randomizedcoder/rtl-fun/README.md

# rtl-fun

**Parser instructions for RISC-V — a CPU-in-the-datapath packet parser as an ISA extension.**

This project takes Tom Herbert's *"parser instructions"* idea — domain-specific
CPU instructions that make protocol parsing fast *and* fully programmable — and
carries it all the way to real RTL: a SystemVerilog RISC-V extension, verified
against a golden software model and prototyped on FPGA.

## Why

Protocol parsing is a parse-graph walk: for each header you must (1) determine
its length and (2) determine the next protocol. Fixed-function parsers are fast
but rigid; plain integer code is flexible but slow (dominated by load/shift/mask/
branch). Making the parser a set of *CPU instructions* gives both: hardware-speed
primitives that live inside a Turing-complete, fully programmable core, reusing
existing tool chains and operational practices.

Reference: Tom Herbert, ["Parser Instructions: World's fastest and most flexible
protocol parsing"](https://tomaherbert.com/parser-instructions-worlds-fastest-most-flexible-protocol-parsing-0d366cd4dfc5)
(US patent 12,461,885).

## Status

🔨 **Executing phase by phase.** The full [design-doc set](docs/README.md) is
complete; phases are now being built in order.

- ✅ **Phase 0 — Scope & stack:** base core locked (CVA6, RV64GC); the stock CVA6
  Verilator model builds end-to-end from Nix (`nix run .#cva6-baseline`) with the
  RISC-V cross-toolchain; reproducibility snapshot in
  [docs/environment.md](docs/environment.md).
- ✅ **Phase 1 — ISA spec:** normative, patent-cited
  [per-instruction semantics](docs/phase-1-isa-semantics.md) for the vertical slice.
- ✅ **Phase 2 — Golden model + corpus:** the C reference model
  (`model/libparsermodel`) parses Ethernet, VLAN (802.1Q/802.1ad, stacked), IPv4
  (with options), IPv6 (with hop-by-hop/routing/fragment/dest-opts extension
  headers), TCP and UDP into a `flow_keys`. It passes directed, malformed (§2.3),
  and corpus tests against a pinned [xdp2](https://github.com/randomizedcoder/xdp2)
  `proto_audit` corpus — all 306 Ethernet pcaps terminate cleanly, no
  crashes/hangs (`nix run .#model-test`). Debug a parse with `nix run .#pm-trace`.
- ✅ **Phase 3 — Instruction encoding:** the patent's bit-accurate scheme
  (custom-0 `0x0b` + `Fnc4`; custom-3 `0x7b` coprocessor) as a machine-readable
  table ([`isa/parser-opcodes.yaml`](isa/parser-opcodes.yaml)) with a C
  encoder/decoder in the model and `.insn` emitters
  ([`toolchain/parser_insn.h`](toolchain/parser_insn.h)); every slice instruction
  round-trips (`nix run .#model-test`).
- ✅ **Phase 4 — Microarchitecture:** the parser datapath (align → endian →
  shift/mask extract, bounds/length/compare, CAM, two-stage end-of-node), a 256 B
  packet buffer with a 128-bit read window, and a 32×64-bit parser register file
  with a single-in-flight hazard interlock — all decided at signal-interface
  granularity. The CVA6 integration is mapped to the **pinned v5.3.0 source**
  ([`docs/analysis/cva6-integration.md`](docs/analysis/cva6-integration.md)):
  custom-0 becomes a new in-pipeline `fu_t::PARSER` that reuses CVA6's
  `resolved_branch_o` path for end-of-node fetch redirect, and the custom-3
  coprocessor moves attach via CV-X-IF.
- ✅ **Phase 5 — RTL:** the parser datapath is implemented in
  synthesizable SystemVerilog ([`rtl/`](rtl/README.md)) as a hardware `pm_run` and
  **runs the vertical slice in Verilator, producing a `flow_keys` that matches the
  golden model byte-for-byte** (`nix run .#parser-sim`). Lint-clean under `-Wall`,
  with four Verilator targets at different debug levels
  (`parser-sim{,-trace,-debug}`, `parser-lint`). The 32-bit word decoder
  (`parser_decode.sv`) is proven equivalent to the model over the whole suite
  (`nix run .#parser-sim-decode`), and the **in-core CVA6 patch is complete**:
  custom-0/custom-3 route to a new `fu_t::PARSER`, issue over a ready/valid
  handshake, execute in the EX-stage FU (`cva6_parser_wrap`), retire via a new
  writeback port, and can redirect fetch via `resolved_branch_o`. The patched core
  builds (`nix run .#cva6-parser`) with no baseline regression, and a bare-metal
  custom-0 program **issues, executes, and retires in-core**
  (`nix run .#cva6-parser-test` → fesvr `tohost` PASS). The **packet-data feed + CAM
  programming are real** (I5): a SoC AXI MMIO peripheral (`nix/cva6-parser/
  mmio.patch`) bridges `sd`/`ld` into the FU's `parser_pktbuf` write port + commit-gated
  flow_keys frame, and the CAM is programmed at runtime from the integer side — so a
  program parses a packet end-to-end in-core. All exit criteria met; the lone leftover
  (generate `parser_pkg` from `isa/`) is a cosmetic refactor, not a gate.
- ✅ **Phase 6 — Verification:** the correctness gate is met — the RTL is proven
  equal to the golden model (fields **and** exit status) across the corpus, and the
  in-core FU is verified end-to-end. The foundation is green across all four
  techniques from the flake: **toggleable design assertions**
  (`rtl/parser_asserts.svh`, on in every sim, gone from synthesis); **SymbiYosys
  formal proofs** — `parser_execute` never writes metadata out of bounds / always
  exits valid, and `cva6_parser_wrap` never leaks speculative parser state past a
  flush (G2 k-induction), for all inputs (`nix run .#parser-formal`); a **directed
  suite** of 22 positive / negative / boundary / corner packets — IPv4/IPv6, VLAN,
  QinQ, IPv6 ext + fragment, malformed and truncated — each matched byte-for-byte and
  by exit code against the model (`nix run .#parser-sim-suite`); and **static
  analysis + fuzzing** — verible + svlint on the RTL (`nix run .#parser-analyze`),
  cppcheck + gcc `-fanalyzer` + clang-tidy + ASan/UBSan on the model
  (`nix run .#model-analyze`), and libFuzzer + ASan/UBSan on random packets
  (`nix run .#model-fuzz`). The in-core FU is hardened through increments **I1–I5**
  (see the [status tracker](docs/analysis/cva6-implementation-status.md)), culminating
  in the full **in-core packet→flow_keys co-simulation over real MMIO** — all 22 corpus
  packets parse in the CVA6 pipeline and match the model **byte-for-byte + exit code**
  (`nix run .#cva6-parser-cosim`, 22/22). A **per-instruction RVFI-vs-Spike lock-step**
  then steps an extended Spike (its custom extension reuses `libparsermodel`) beside
  the core and compares every retired instruction — base ISA (287/287), parser ops
  (43/0), the 22-packet corpus (0 mismatches) — plus a **constrained-random +
  real-corpus packet campaign** (`nix run .#cva6-parser-tandem` /
  `.#cva6-parser-tandem-campaign`). *(That lock-step tandem is the project's Phase-6
  verification oracle; its PRs are commit-tagged "Phase 7 Stage N", but the work is
  classified as Phase-6 verification, not the Phase-7 toolchain.)* Sign-off is
  complete: **negative control** (`nix run .#parser-negative-control`, G11),
  **base-ISA regression** (`nix run .#cva6-parser-baseisa`), a **2nd config**
  (`nix run .#cva6-parser-config-wb`, G10), the interrupt / fault / context-switch
  rows (V6/V7/V10/M1), and **coverage closure** (`nix run .#parser-coverage`, 100% of
  the functional op×event×exit bins, G12). Gaps **G1–G13 are closed**; **G14
  (timing/physical) belongs to Phase 8**. The only §6.1 item not built as literally
  specified — a **cocotb + DPI-C** corpus harness — is *superseded*: its goal is met
  by the Verilator suite + in-core MMIO cosim + tandem campaign.
- 🔵 **Phase 7 (in progress) — Toolchain:** the software-tooling ladder. **Level 1**
  (`.insn` + intrinsics, [`toolchain/parser_insn.h`](toolchain/parser_insn.h)) and
  **Level 2** (binutils as/objdump — a parser-patched `riscv64-none-elf` binutils
  assembles the `prs.*` mnemonics with readable, round-tripping disassembly — Hybrid
  syntax plus additive prose sugar `pcurptr+N`/`paccum[i]`/`value:mask`;
  `nix run .#parser-asm-test`) are done, **Level 4 Spike** runs standalone
  (`nix run .#parser-spike`: a runnable `spike` with the parser extension + `0x5000_0000`
  packet MMIO runs the 22-case corpus == the golden model — distinct from the Phase-6
  `spike-tandem` oracle), and the **slice parser is now authored in C** with the generated
  intrinsics ([`tests/cva6-parser/parser_slice.c`](tests/cva6-parser/parser_slice.c),
  `nix run .#parser-spike-slice`: byte-identical to the model ROM, 22-case corpus == model
  on the standalone Spike). **Level 4 QEMU** then teaches a patched `qemu-system-riscv64` the
  same ops + `0x5000_0000` device ([`nix/qemu-parser.nix`](nix/qemu-parser.nix)) and runs the
  identical ELFs and C slice on it (`nix run .#parser-qemu` / `.#parser-qemu-slice`, both
  22/0 == model) — so **the exit criterion is met: the C slice runs on Spike *and* QEMU ==
  the golden model** ✅. The prose-freeze follow-on is now **complete** too — the frozen §1.12
  notation (`.be`/`.stp`/`.fail` qualifiers, `mult:min`, the `prs.lenset{,min,const}` aliases, and
  the `paccum`/`pnext`/`pcurhdr` destination decoration) assembles, disassembles to the canonical
  prose, and round-trips, all bit-identical to the model. **LLVM MC** is progressing (`nix run
  .#parser-llvm-mc-test`): a RISCV-only patched `llvm-mc`/`llvm-objdump`, generated from the same
  ISA yaml, assembles + disassembles the immediate-only custom-0 ops (L1), the custom-3 moves via a
  generated `PRReg` register class (L2), the destination-decorated load/cam/length forms (L3a:
  `paccum`/`pnext`/`pcurhdr`), and the prose-sugar operands (L3b: `pcurptr+N`, `pmeta+N`,
  `paccum[i]`, `value:mask`, `mult:min`) to byte-identical goldens — full binutils parity for the
  MC layer (all 38 vector lines assemble + round-trip, 0 deferred). The **Clang** leg has stood up
  (C0, `nix run .#parser-clang-check`): a `clang` built against the parser-patched libLLVM whose
  integrated assembler assembles `prs.*` to the golden words and compiles the C slice byte-identical
  to the model ROM. On top of it, **C1** adds `__builtin_riscv_prs_*` — 67 first-class Clang builtins
  (one per assembly variant) generated from the same ISA yaml, with Sema immediate-range checking,
  each lowering to the `prs.*` mnemonic as inline asm (no IR intrinsics / ISel);
  `nix run .#parser-clang-builtins-test` proves every one emits the exact golden encoding (67/0).
  **C2** ran that C slice through the patched Clang using those builtins (`-DPRS_USE_BUILTINS`) on the
  standalone Spike over the 22-case corpus == the golden model, the 53-word byte-parity guard proving
  the builtins lowering is byte-identical to the intrinsics one (`nix run .#parser-clang-slice`). **C3**
  completes the leg with the custom-3 register-move builtins (`__builtin_riscv_prs_mv_x_p` / `mv_p_x` /
  `cam_read` / `array_read`) — reading/writing the parser p-registers from Clang — verified by a
  table-driven masked encoding check plus a builtins-only p-register round-trip on Spike
  (`nix run .#parser-clang-moves`). The exit criterion is met and the whole toolchain ladder a C
  programmer needs is built; what remains is a **follow-up tail** (optional GCC **builtins**, the
  unfrozen `prs.ld.immed` immediate spelling, and the heavyweight random-*instruction* checks — full
  upstream riscv-tests; riscv-dv, blocked on a commercial UVM simulator), none of it on the critical
  path — so **Phase 8 can begin**. The deferred items are enumerated in
  [docs/phase-7-toolchain.md](docs/phase-7-toolchain.md#follow-up--deferred-work).

- 🔵 **Phase 8 (in progress) — FPGA:** the board is real. A **Sipeed Tang Mega 138K Pro**
  (Gowin `GW5AST-LV138FPG676AC1/I0` — 138,240 LUT4, 1 GB DDR3, 2× SFP+) arrived and was
  powered up on **2026-09-07**, unblocking the one thing this phase was waiting for.
  Current scope is board bring-up: prove we can talk to it, program it, and run **our own**
  RTL on it. The programming path is in the flake — `nix run .#fpga-detect` (scan the JTAG
  chain), `.#fpga-load` / `.#fpga-flash` (SRAM / SPI flash), `.#fpga-build` (synthesize via
  Gowin EDA in the licensed microVM) — Gowin EDA is now a derivation rather than a
  hand-extracted directory ([`nix/gowin-eda.nix`](nix/gowin-eda.nix)), and the first design
  we build ourselves lives in [`fpga/tang-mega-138k-pro/`](fpga/tang-mega-138k-pro/).
  The standing hands-on reference — pin map, the two USB ports, Gowin gotchas — is
  [docs/fpga-bringup-tang-mega-138k-pro.md](docs/fpga-bringup-tang-mega-138k-pro.md);
  progress, measurements and the challenge log are in
  [docs/phase-8-status.md](docs/phase-8-status.md).
  **M0 (bring-up), M1 (parser unit alone) and M2 (host packet injection) are done and
  verified on the board:** the parser datapath runs on the FPGA and produces `flow_keys`
  that match `libparsermodel` byte-for-byte — M1 from a ROM-baked packet
  (`nix run .#fpga-m1-check`), M2 for the **whole 22-case suite injected over UART**
  (`nix run .#fpga-m2-inject -- --suite`, 22/22). GowinSynthesis can't ingest our RTL
  directly (an `SP00018` front-end bug), so the flow is sv2v → yosys flatten → Gowin
  (`nix run .#fpga-m{1,2}-rtl`). The debug UART's RX pin is CPU-locked, so M2 injects over
  an external 3.3 V USB-UART on PMOD2. Next is **M3 (stock CVA6 on the FPGA)**; its known
  blocker is BRAM inference for CVA6's SRAM macros
  ([docs/fpga-platform-assessment.md](docs/fpga-platform-assessment.md) §5a).

The parser unit now exists as synthesizable RTL ([`rtl/`](rtl/README.md)), with its
testbenches in [`tb/`](tb/README.md) and the vector generator + formal harness in
[`verif/`](verif/README.md); `fpga/` now holds the Tang Mega board designs, and `corpus/`
remains a skeleton until its phase lands (per-phase status: [docs/README.md](docs/README.md)). Deferred: 64-bit instruction
form, the array/counter/TLV-loop encoder+execution, and tunnel protocols
(GRE/GTP/VXLAN).

## Repo map

```
docs/          Design documentation (start here; testing map: docs/testing-overview.md)
model/         Golden C reference model            (Phase 2)
isa/           Machine-readable encoding tables     (Phase 3)
rtl/           SystemVerilog parser unit — synthesizable RTL only (Phase 5)
tb/            SystemVerilog testbenches (scaffold + smoke + wrap) (Phase 6)
verif/         Vector generator (verif/gen) + formal harness (verif/formal) (Phase 6)
tests/         In-core CVA6 test programs (parser_insn.S, cosim_main.S) (Phase 5/6)
scripts/       Bodies of the `nix run .#<app>` runners (readFile'd into nix)
tools/         Reusable dev utilities (pm-trace, bitgen)
corpus/        Packet corpus skeleton (incl. malformed) (Phase 2)
toolchain/     .insn macros, intrinsics, MMIO map      (Phase 7)
fpga/          Board designs + Gowin build scripts  (Phase 8)
bench/         Benchmark harness + results          (Phase 9)
flake.nix      Nix flake — reproducible dev environment (`nix develop`)
nix/           Modular Nix files (tool groups, dev shell, CVA6 patches)
LICENSE        Public domain (Unlicense)
```

## Development environment

All tooling (Verilator, cocotb, poppler, Spike, QEMU, …) is provided by a **Nix
flake** so every contributor gets the same versions:

```sh
nix develop      # enter the dev shell
rtl-help         # list the tools
```

See **[docs/nix.md](docs/nix.md)** for the layout and how to extend it.

## Read the docs

| Doc | What it covers |
|-----|---|
| [docs/README.md](docs/README.md) | Index + reading order + phase status |
| [docs/00-overview.md](docs/00-overview.md) | **The whole-project design doc — start here** |
| [docs/testing-overview.md](docs/testing-overview.md) | **How the parser is tested** — the four test layers + which `nix run` runs each |
| [Phase 0 — Scope & stack](docs/phase-0-scope-and-stack.md) | Goals, core selection, first vertical slice |
| [Phase 1 — ISA spec](docs/phase-1-isa-spec.md) | Parser registers & instruction semantics |
| [Phase 2 — Reference model](docs/phase-2-reference-model.md) | Golden C model + packet corpus |
| [Phase 3 — Encoding](docs/phase-3-encoding.md) | `custom-0..3` opcode allocation |
| [Phase 4 — Microarchitecture](docs/phase-4-microarchitecture.md) | Parser datapath & core integration |
| [Phase 5 — RTL](docs/phase-5-rtl.md) | SystemVerilog implementation |
| [Phase 6 — Verification](docs/phase-6-verification.md) | Co-simulation vs golden model |
| [Phase 7 — Toolchain](docs/phase-7-toolchain.md) | Assembler, LLVM/GCC, Spike/QEMU |
| [Phase 8 — FPGA](docs/phase-8-fpga.md) · [**status**](docs/phase-8-status.md) · [board manual](docs/fpga-bringup-tang-mega-138k-pro.md) | Prototype & bring-up |
| [Phase 9 — Benchmark](docs/phase-9-benchmark.md) | flow_dissector comparison |

## How to read

Read `docs/00-overview.md` first for the full picture, then follow the phase docs
in order. Each phase doc is self-contained and links to the previous/next phase.
Anything not yet locked down is marked **TBD** or **Decision** so the docs stay
honest about what's decided vs. open.
