randomizedcoder/rtl-fun/docs/README.md

# Design docs — index

This folder plans the entire project: from Tom Herbert's *parser instructions*
concept to real SystemVerilog RTL for a RISC-V ISA extension, verified against a
golden model and prototyped on FPGA.

## Reading order

1. **[00-overview.md](00-overview.md)** — the centerpiece design doc. Read first.
2. The phase docs, in order (each builds on the last):

| Phase | Doc | Objective | Status |
|---:|-----|---|---|
| 0 | [Scope & stack](phase-0-scope-and-stack.md) | Lock goals, base core, first vertical slice | ✅ Done |
| 1 | [ISA spec](phase-1-isa-spec.md) · [**semantics**](phase-1-isa-semantics.md) | Define parser registers & instruction semantics | ✅ Done |
| 2 | [Reference model](phase-2-reference-model.md) | Golden C model + packet corpus | ✅ Done |
| 3 | [Encoding](phase-3-encoding.md) | Allocate `custom-0..3` opcodes & formats | ✅ Done |
| 4 | [Microarchitecture](phase-4-microarchitecture.md) | Parser datapath + core integration | ✅ Done |
| 5 | [RTL](phase-5-rtl.md) | SystemVerilog implementation | ✅ Done |
| 6 | [Verification](phase-6-verification.md) | Co-sim RTL vs golden model | ✅ Done |
| 7 | [Toolchain](phase-7-toolchain.md) | Assembler → LLVM/GCC → Spike/QEMU | 🔵 In progress |
| 8 | [FPGA](phase-8-fpga.md) · [**status**](phase-8-status.md) · [board manual](fpga-bringup-tang-mega-138k-pro.md) | Prototype & bring-up on hardware | 🔵 In progress |
| 9 | [Benchmark](phase-9-benchmark.md) | flow_dissector comparison | 🟡 Draft |

Status legend (tracks phase **execution**, not just the doc):
🟡 Draft (design written, not yet executed) · 🔵 In progress (being executed) ·
✅ Done (executed & merged to `main`).

**Progress:** Phase 0 done — CVA6 Verilator baseline builds from Nix
(`nix run .#cva6-baseline`) with the RISC-V cross-toolchain and a reproducibility
snapshot ([environment.md](environment.md)). Phase 1 done — the normative
[per-instruction semantics](phase-1-isa-semantics.md) are complete and patent-cited.
Phase 2 done — the golden C model (`model/libparsermodel`) parses Ethernet,
802.1Q/802.1ad VLAN (incl. stacked), IPv4 (with options), IPv6 (with hop-by-hop /
routing / fragment / dest-opts extension headers), TCP and UDP into a `flow_keys`.
It passes directed unit tests, hostile/malformed cases (§2.3), and a robustness
sweep over the pinned xdp2 `proto_audit` corpus — all 306 Ethernet pcaps
terminate cleanly, no crashes/hangs (`nix run .#model-test`). A single-step
tracer lives in [tools/pm-trace](../tools/README.md).
Phase 3 done — the bit-accurate encoding is captured as a machine-readable table
([`isa/parser-opcodes.yaml`](../isa/parser-opcodes.yaml)), with a C encoder/decoder
wired into the model ([`encoding.c`](../model/libparsermodel/encoding.c)) and
`.insn` emitters ([`toolchain/parser_insn.h`](../toolchain/parser_insn.h)). Every
instruction in the slice program encodes to its exact custom-0 word and decodes
back (round-trip + golden-vector tests in `nix run .#model-test`).
Phase 4 done — the parser microarchitecture is decided at signal-interface
granularity: a 256 B packet buffer with a 128-bit read window, the extract/length/
compare/CAM/end-of-node datapath and its unit interfaces, a 32×64-bit parser
register file with a single-in-flight hazard interlock, and a CVA6 integration
plan mapped to the **pinned v5.3.0 source** — custom-0 as a new in-pipeline
`fu_t::PARSER` reusing `resolved_branch_o` for end-of-node redirect, custom-3 via
CV-X-IF ([`analysis/cva6-integration.md`](analysis/cva6-integration.md)).
Phase 5 done — the parser datapath is implemented in synthesizable
SystemVerilog ([`rtl/`](../rtl/README.md)) as a hardware `pm_run`, and **runs the
vertical slice in Verilator producing a `flow_keys` that matches the golden model
byte-for-byte** (`nix run .#parser-sim`). Lint-clean under `-Wall`, with four
Verilator targets at different debug levels (run / trace / debug / lint). The FU
also runs in-core in CVA6: the decode/issue/EX/retire patch is complete, the
32-bit-word decoder (`parser_decode`) is proven vs the model, and a packet parses
end-to-end in the pipeline over real MMIO ([`analysis/cva6-integration.md`](analysis/cva6-integration.md) §8).
All Phase-5 exit criteria are met; the one remaining nicety — generating
`parser_pkg` constants from `isa/` — is a cosmetic refactor, not a gate.
Phase 6 done — the correctness gate is met: the RTL is proven equal to the
golden model (fields **and** exit status) across the corpus, and the in-core FU is
verified end-to-end. The verification *foundation* is green across all four
techniques from the flake: (1) **toggleable design assertions**
(`rtl/parser_asserts.svh`) compiled into every sim and vanishing from synthesis;
(2) **SymbiYosys formal proofs** — `parser_execute` never writes metadata out of
bounds and always exits with a valid code, and `cva6_parser_wrap` never leaks
speculative parser state past a flush (G2 k-induction) — for *all* inputs
(`nix run .#parser-formal`); (3) a **directed suite** of 22 positive / negative /
boundary / corner packets — IPv4/IPv6, VLAN, QinQ, IPv6 ext + fragment, malformed
and truncated frames — each matched byte-for-byte and by exit code against the
model (`nix run .#parser-sim-suite`); and (4) **static analysis + fuzzing** —
verible + svlint on the RTL (`nix run .#parser-analyze`), cppcheck + gcc
`-fanalyzer` + clang-tidy + ASan/UBSan on the model (`nix run .#model-analyze`),
and libFuzzer + ASan/UBSan on random packets (`nix run .#model-fuzz`).
The in-core FU is hardened through increments **I1–I5**: the full **in-core
packet→flow_keys co-simulation over real MMIO** parses all 22 corpus packets in the
CVA6 pipeline and matches the model byte-for-byte + exit code
(`nix run .#cva6-parser-cosim`, 22/22). A **per-instruction RVFI-vs-Spike
lock-step** then steps an extended Spike beside the core and compares every retired
instruction — base ISA (287/287), the parser ops (43/0), and the 22-packet corpus
(0 mismatches) — with a **constrained-random + real-corpus packet campaign** layered
on top (`nix run .#cva6-parser-tandem` / `.#cva6-parser-tandem-campaign`). This
lock-step tandem (its Spike custom extension reuses `libparsermodel`) is the
project's **Phase-6 verification oracle** — the commit banners on those PRs say
"Phase 7 Stage N", but the work is classified here as Phase-6 verification, not the
Phase-7 toolchain. Sign-off is complete: **negative control**
(`nix run .#parser-negative-control`, G11), **base-ISA regression** on the patched
core (`nix run .#cva6-parser-baseisa`), a **2nd config** (`nix run
.#cva6-parser-config-wb`, G10), the interrupt / fault / context-switch rows
(V6/V7/V10/M1), and **coverage closure** (`nix run .#parser-coverage`, 100% of the
functional op×event×exit bins, G12). Gaps **G1–G13 are closed**; **G14
(timing/physical) is Phase 8**. The one item from the original §6.1 plan not built
as specified is the **cocotb + DPI-C** corpus harness — its goal (RTL == model over
the corpus) is met by the standalone Verilator suite + the in-core MMIO cosim + the
tandem campaign, so it is recorded as *superseded*, not outstanding.
Phase 7 in progress — the toolchain ladder. **Level 1** (`.insn` + intrinsics,
[`toolchain/parser_insn.h`](../toolchain/parser_insn.h)) and **Level 2** (binutils
as/objdump — a parser-patched `riscv64-none-elf` binutils assembles the `prs.*`
mnemonics with readable, round-tripping disassembly, generator-driven — Hybrid syntax plus
additive prose sugar (`pcurptr+N`, `paccum[i]`, `value:mask`); `nix run .#parser-asm-test`)
are done, **Level 4 Spike** runs standalone (`nix run .#parser-spike`: a runnable
`spike` with the parser extension + `0x5000_0000` packet MMIO, [`nix/spike-parser.nix`](../nix/spike-parser.nix),
runs the 22-case corpus == the golden model — distinct from the Phase-6 `spike-tandem` oracle),
and the **slice parser is now written in C** with the generated intrinsics
([`tests/cva6-parser/parser_slice.c`](../tests/cva6-parser/parser_slice.c),
`nix run .#parser-spike-slice`: byte-identical to the model ROM, 22-case corpus == model on the
standalone Spike). **Level 4 QEMU** teaches a patched `qemu-system-riscv64` the same ops +
`0x5000_0000` device ([`nix/qemu-parser.nix`](../nix/qemu-parser.nix)) and runs the identical
ELFs and C slice on it (`nix run .#parser-qemu` / `.#parser-qemu-slice`, both 22/0 == model) —
so **the exit criterion is met: the slice runs on Spike *and* QEMU == the golden model** ✅.
The prose-freeze follow-on is now **complete** — the frozen §1.12 notation (`.be`/`.stp`/`.fail`
qualifiers, `mult:min`, the `prs.lenset{,min,const}` aliases, `paccum`/`pnext`/`pcurhdr` destination
decoration) assembles, disassembles to the canonical prose, and round-trips, all bit-identical to
the model. **LLVM MC** is progressing (`nix run .#parser-llvm-mc-test`): a RISCV-only patched
`llvm-mc`/`llvm-objdump`, generated from the same ISA yaml, assembles + disassembles the
immediate-only custom-0 ops (L1), the custom-3 moves via a generated `PRReg` register class (L2),
the destination-decorated load/cam/length forms (L3a: `paccum`/`pnext`/`pcurhdr`), and the
prose-sugar operands (L3b: `pcurptr+N`, `pmeta+N`, `paccum[i]`, `value:mask`, `mult:min`) to
byte-identical goldens — full binutils parity for the MC layer (all 38 vector lines assemble +
round-trip, 0 deferred). The **Clang** leg has stood up (C0, `nix run .#parser-clang-check`): a
`clang` built against the parser-patched libLLVM, whose integrated assembler assembles `prs.*` to
the golden words and compiles the C slice byte-identical to the model ROM. On top of it, **C1** adds
`__builtin_riscv_prs_*` — 67 first-class Clang builtins (one per assembly variant) generated from the
same ISA yaml, with Sema immediate-range checking, each lowering to the `prs.*` mnemonic as inline asm
(no IR intrinsics / ISel); `nix run .#parser-clang-builtins-test` proves every one emits the exact
golden encoding (67/0). **C2** ran the Phase-0 C slice through the patched Clang using those builtins
(`-DPRS_USE_BUILTINS`) on the standalone Spike over the 22-case corpus == the golden model, the 53-word
byte-parity guard proving the builtins lowering is byte-identical to the intrinsics one
(`nix run .#parser-clang-slice`). **C3** completes the leg with the custom-3 register-move builtins
(`__builtin_riscv_prs_mv_x_p`/`mv_p_x`/`cam_read`/`array_read`, reading/writing the parser p-registers
from Clang) — a table-driven masked encoding check + a builtins-only p-register round-trip on Spike
(`nix run .#parser-clang-moves`). The exit criterion is met and the full toolchain ladder is built;
what remains is a **follow-up tail** — optional GCC **builtins**, the unfrozen `prs.ld.immed` immediate
spelling, and the heavyweight random-*instruction* checks (full upstream riscv-tests, riscv-dv — the
latter blocked on a commercial UVM simulator) — none of it on the critical path, so **Phase 8 can
begin**. The items are enumerated in
[phase-7-toolchain.md](phase-7-toolchain.md#follow-up--deferred-work).
Deferred slices: 64-bit instruction form; encoders/execution for the array /
counter / TLV-loop groups; TLV *extraction* loops and tunnel protocols.

Phase 8 in progress — the board is real. The **Sipeed Tang Mega 138K Pro**
(Gowin `GW5AST-LV138FPG676AC1/I0`) arrived and was powered up on 2026-09-07,
unblocking the one thing Phase 8 was waiting for. The hands-on reference is
[fpga-bringup-tang-mega-138k-pro.md](fpga-bringup-tang-mega-138k-pro.md) — pin map,
the two USB ports, the Gowin gotchas, and a live what-works/what-doesn't table.
The programming path is in the flake (`nix run .#fpga-detect` / `.#fpga-load` /
`.#fpga-flash` / `.#fpga-build`), Gowin EDA is now a derivation rather than a
hand-extracted directory ([`nix/gowin-eda.nix`](../nix/gowin-eda.nix)), and the
first design we build ourselves lives in
[`fpga/tang-mega-138k-pro/`](../fpga/tang-mega-138k-pro/). Current scope stops at a
self-built blinky; UART hello world is next, and the known blocker beyond it is
BRAM inference for CVA6's SRAM macros.

## Analysis

- **[analysis/cva6-integration.md](analysis/cva6-integration.md)** — the file/signal
  map for attaching the parser unit to CVA6, grounded in the pinned v5.3.0 source:
  custom opcodes, `fu_t::PARSER`, the `resolved_branch_o` end-of-node redirect,
  CV-X-IF for the custom-3 moves, and the Phase-5 patch checklist.
- **[analysis/cva6-test-evaluation.md](analysis/cva6-test-evaluation.md)** — a
  tapeout-oriented risk register for the **in-core** parser test: what
  `cva6-parser-test` actually proves, the bug-class gaps (incl. a speculation/flush
  state-corruption risk), and the industry best practices (lock-step co-sim,
  `riscv-dv`, RVFI/formal) to close them.
- **[analysis/cva6-verification-design.md](analysis/cva6-verification-design.md)** —
  the follow-up *design*: ordered implementation increments that close those gaps
  (starting with the speculation-safety fix), a **table-driven** verification
  framework (positive/negative/boundary/corner, model-generated oracles), and a
  **manufacturing/self-test (DFT)** section — scan/ATPG, MBIST/CAM-BIST for the
  parser memories, JTAG, and a golden-vector power-on self-test (POST).
- **[analysis/cva6-implementation-status.md](analysis/cva6-implementation-status.md)**
  — the **live progress tracker** for executing that design (increments I1–I5, gap
  burn-down G1–G14, verification-target snapshot). Updated per PR. I1
  (speculation-safety, commit-visible parser state), I2 (commit-gated metadata sink),
  I3 (custom-3 register readback), I4 (end-of-node + CAM-hit fetch redirect), and
  **I5** (all op classes + model-generated encodings + the table-driven in-core
  packet→flow_keys cosim over **real MMIO** — which closes the I2 sim-only-backdoor
  escalation) are all done and green in-core.
- **[analysis/cva6-parser-mmio.md](analysis/cva6-parser-mmio.md)** — the I5 SoC AXI
  MMIO parser peripheral: the address map (packet buffer, flow_keys frame, ParseLen /
  exit-PC / status registers), how `sd`/`ld` bridge through `axi2mem` into the FU, the
  gated parse-exit fetch redirect, and the **registered-read** gotcha (`axi2mem`
  advances the beat address combinationally, so a peripheral must present 1-cycle read
  data or every `ld` returns the next word).
- **[analysis/patent-conformance.md](analysis/patent-conformance.md)** — how the
  design compares to US Patent 12,461,885, and the prioritized corrections applied to
  follow Herbert's model closely.
- **[analysis/patent-encodings-recovered.md](analysis/patent-encodings-recovered.md)**
  — the authoritative bit-level reference: `Fnc4` opcode map, every 32-bit
  instruction format as RFC-style ASCII bit diagrams, the Parser Codes table, `Sz`
  tables, address/code + CAM-key formats, and register layouts (pixel-verified from
  the USPTO drawing sheets).

## Supporting docs

- **[testing-overview.md](testing-overview.md)** — **start here for "how is the parser
  tested?"** The one-stop map of the four test layers (golden-model unit/fuzz,
  standalone RTL-vs-model suite, in-core directed, in-core cosim-vs-model + formal),
  which `nix run .#<app>` runs each, where each lives, and how one generator feeds
  both the standalone suite and the cosim.
- **[fpga-bringup-tang-mega-138k-pro.md](fpga-bringup-tang-mega-138k-pro.md)** —
  **start here for "how do I use the FPGA?"** The board manual: pin map, the two
  USB ports, host permissions, the `nix run .#fpga-*` ladder, and the Gowin
  gotchas. Stable reference — it does not track progress.
- **[phase-8-status.md](phase-8-status.md)** — the Phase-8 **live progress tracker
  and challenge log**: what is done, measured utilization/timing, and a
  symptom → cause → resolution table for every problem hit on the way.
- **[gowin-microvm.md](gowin-microvm.md)** — the licensed Gowin EDA harness: why a
  VM (the license is node-locked to a MAC), the marker-file autorun, and the
  license/device/headless troubleshooting notes.
- **[fpga-platform-assessment.md](fpga-platform-assessment.md)** — the pre-purchase
  board study: why this board, what fits, and the Xilinx fallback.
- **[nix.md](nix.md)** — the Nix dev environment (`nix develop`), its layout, and how to extend it.
- **[environment.md](environment.md)** — pinned tool versions (the Phase 0 reproducibility snapshot).
- **[glossary.md](glossary.md)** — terms (parse graph, cursor, TLV, CAM, custom0-3, IPC, XDP2/PANDA…).
- **[references.md](references.md)** — external links (blog, patent, RISC-V spec, CVA6/Ibex, flow_dissector, tooling).

## Conventions

- **Format:** Markdown with ASCII block diagrams — portable and diff-friendly.
  (Mermaid is fine where a renderer is available, but keep an ASCII fallback.)
- **Per-phase template:** every phase doc follows the same skeleton —
  *Objective · Inputs/prereqs · Design detail · Step-by-step tasks · Deliverables ·
  Exit criteria · Open questions · References.*
- **Honesty markers:** unresolved specifics are tagged **TBD** or **Decision**.
- **Layer discipline:** ISA semantics, microarchitecture, and RTL are kept
  strictly separate. The ISA spec (Phase 1) never encodes cycle counts.
