randomizedcoder/rtl-fun/bench/README.md

# bench/ — benchmark harness + results (Phase 9)

Methodology and results comparing the parser-ISA path against optimized plain
RV64 and a Linux `flow_dissector`-style baseline: cycles/packet, instruction
count, and IPC. Reference targets from the blog: ~15:1 instruction-count and
~4.3× throughput.

*Empty until Phase 9. See [`docs/phase-9-benchmark.md`](../docs/phase-9-benchmark.md).*
