randomizedcoder/rtl-fun/docs/fpga-platform-assessment.md

# FPGA Platform Assessment — pre-purchase feasibility for CVA6 + parser

← [Phase 8](phase-8-fpga.md) · [Tang Mega bring-up plan](tang-mega-138k-pro-rtl-fun-plan.md) · [Docs index](README.md)

> **Status: pre-purchase evaluation.** This document records a software-only feasibility
> study performed *before* committing to an FPGA board, to answer: **is the Sipeed Tang
> Mega 138K Pro (Gowin GW5AST-138) a sound target for CVA6 + the packet-parser extension,
> or is another board a better buy?** Everything here was determined on the NixOS
> workstation with no FPGA hardware. Date of study: 2026-08.

## TL;DR — should I buy the Tang Mega 138K Pro, and will it work?

**Short answer: yes, it will work for this project — but it is the *endgame* board, not the
*prototyping* board.** Every make-or-break question came back green, with one caveat that is effort,
not a blocker:

| Question | Verdict |
| --- | --- |
| Will the design **fit**? | ✅ **Yes.** CVA6 `cv64a6_imafdc` fits with proper BRAM mapping (real logic ≈15K FF; caches ≈9% of the 6.12 Mbit block RAM — §5a). The parser add-on is **negligible** (~6K LUT4 — §2). Room to spare on a 138K-LUT4 / 340-BSRAM part. |
| Can it be **built** (toolchain + license)? | ✅ **Yes.** The NODELOCK **Gowin license synthesizes AND place-and-routes** the exact part (Tier-1 GO, real bitstream — §4) — with the **commercial** IDE 1.9.12.03; the Education edition does not carry this part number (see §4), and full CVA6 **elaborates + synthesizes** in GowinSynthesis (§5a). |
| Does the **I/O** match the goal? | ✅ **Best in class.** 2× SFP+ (10 GbE), DDR3, PCIe — the strongest fit of any candidate for the 10 GbE endgame, and it's cheap. |
| The catch? | ⚠️ **Integration effort.** No CVA6 FPGA reference design for Gowin; CVA6's SRAM macros must be mapped onto Gowin BSRAM by hand, and the SV→Gowin path needs care (we hit `$bits` + config-struct friction via sv2v). This is the "highest integration effort" board (§6, #5). |

**Recommendation.**
- **If you want the fastest path to a working CVA6 + parser prototype:** start on a **Xilinx** board
  with the official CVA6 FPGA reference design — **Genesys 2** (#1, lowest risk) or **Artix-7 A200T**
  (#2, free Vivado WebPACK). Turnkey memory/BRAM, GbE, DDR3.
- **If the 10 GbE / SFP+ endgame is the priority** (and it is, for this project) **and you accept the
  integration work:** the **Tang Mega 138K Pro is the right buy** — uniquely suited I/O, cheap, and
  the license is already in hand and proven on the part.
- **Ideal:** prototype on Xilinx (turnkey), then port to the Tang Mega for the 10 GbE endgame. If
  budget is a single board and 10 GbE is essential, buy the Tang Mega and plan for the SRAM/BRAM
  integration up front.

### Which SKU — 138K **Pro**, not the non-Pro 138K

> **Decision (2026-08): the Tang Mega 138K *Pro* is ordered** (arriving ~Sept 2026) — the part this
> study validated. Buy the **Pro**, not the plain 138K; they share the same FPGA *die* but differ
> exactly where this project needs it:

| | **138K Pro** ✅ | **138K** (non-Pro) ❌ |
| --- | --- | --- |
| FPGA part | `GW5AST-LV138`**`FPG676`**`AC1/I0` — **the exact device validated here** (license + CVA6 fit) | `GW5AST-LV138`**`PG484`**`AC1/I0` — same die, 484-ball, fewer I/O |
| **SFP+ (the 10 GbE endgame)** | **2× SFP+, up to 12.5 Gbps** | **none** |
| High-speed transceivers | 8 (to 12.5 Gbps) | 4 (**capped at 8.0 Gbps** — below 10 GbE line rate) |
| DDR3 | 1 GB @ 1333 Mbps | 1 GB @ 800 Mbps |

Both are SOM + dock modules with PCIe 3.0 x4 and 1× GbE RJ45. For a 10 GbE packet-parser the non-Pro
is a dead end (no SFP+, transceivers below 10 Gbps).

### The die also carries a *hardened* RISC-V (Andes A25 / AE350) — a bonus, not a substitute

The GW5AST-138 is a 22 nm **SoC-FPGA**: it embeds a **hardened** Andes A25 + AE350 subsystem (real
silicon, ~400–800 MHz, **consumes zero of the 138 K LUTs**) — present on *both* SKUs. It does **not**
replace this project's core: the A25 is a fixed **32-bit (RV32)** Andes core, so it can't carry the
patent's custom parser opcodes and isn't RV64GC. The **CVA6 (RV64GC) + parser extension still lives
in the FPGA fabric** (that's what §5/§5a size). The hardened A25 is a **free control-plane / Linux
housekeeping CPU** — useful to boot the SoC, manage DMA, and drive the parser — running alongside the
fabric design, not instead of it.
Sources: [Gowin + Andes hardened A25/AE350 announcement](https://www.andestech.com/en/2023/08/29/gowin-semiconductor-andes-technology-corp-announce-the-first-risc-v-cpu-and-subsystem-ever-embedded-22nm-soc-fpga/) ·
[eeNews: first 22 nm FPGA with hardened RISC-V](https://www.eenewseurope.com/en/first-22nm-fgpa-with-hardened-risc-v-cores/) ·
[Tang Mega 138K Pro wiki](https://wiki.sipeed.com/hardware/en/tang/tang-mega-138k/mega-138k-pro.html)

The rest of this document is the evidence behind that verdict.

## 1. Question and method

The Phase 8 goal is to run CVA6-plus-parser on real hardware and parse Ethernet. Before
buying a board, we wanted to de-risk the two make-or-break questions cheaply:

1. **Capacity** — does CVA6 + the parser fit on the candidate device, with headroom for a
   packet buffer, counters, and (later) DDR / Ethernet?
2. **Toolchain** — can the design actually be built for the device with an available,
   reproducible flow?

**Method.** We reused the repo's existing `sv2v` + `yosys` machinery (already used by
`parser-formal`) to flatten SystemVerilog to Verilog-2005 and run **generic synthesis with
LUT4 mapping** (`synth -lut 4`), because the Gowin GW5AST is a **LUT4** architecture. This
gives a rough, vendor-independent gate estimate. We measured the **parser unit** directly,
and **attempted** the full CVA6 core (config `cv64a6_imafdc_sv39`, RV64GC with FPU).

**Tooling (pinned, reproducible):**

| Tool | Version / pin |
| --- | --- |
| nixpkgs | `867dcbc30bafe3c862ef88620f2e7a109d7d3be5` |
| yosys | 0.67 |
| sv2v | 0.0.13.1 (`haskellPackages.sv2v`) |
| CVA6 | v5.3.0 (`openhwgroup/cva6` rev `2ef1c1b…`), config `cv64a6_imafdc_sv39` |

> **Important caveat.** Generic yosys `synth -lut 4` is a *proxy*, not a verdict. It does
> not infer block RAM or DSPs (memory maps to flip-flops/LUTs), and its mapper differs from
> a vendor's. The authoritative area/timing numbers must come from the target vendor's
> synthesis tool. These estimates are for **relative sizing and a buy/no-buy call**, not
> sign-off.

## 2. Finding A — the parser add-on is negligible ✅

The parser datapath synthesizes cleanly. LUT4 mapping (generic yosys):

| Module | LUT4 | FF | Note |
| --- | ---: | ---: | --- |
| `parser_execute` (the functional unit) | ~4,148 | — | combinational compute; includes some standalone-synthesis latch inflation |
| `parser_cam` | ~1,676 | 1,696 | small CAM → **block RAM** on a real target |
| `parser_pktbuf` | ~19,432 | 2,048 | **misleading**: the 256-byte packet buffer maps to flip-flops here; → **1–2 block SRAMs** on a real target, LUTs collapse |
| `parser_decode` | 169 | — | trivial |

**Net logic footprint ≈ 6K LUT4 + a handful of block-SRAMs** once memory maps to BRAM
(as every real FPGA flow does). Against any mid-size FPGA this is a rounding error.

> **Conclusion:** the parser extension — the whole point of this project — is **not** the
> FPGA constraint. It is small and portable, and drops onto any host core. **The host core
> (CVA6) dictates the board.**

## 3. Finding B — CVA6 will not build through the open-source flow

Attempting the full `cva6` core through `sv2v → yosys` hit a **chain of seven distinct
failures**, each a different construct in CVA6's heavily machine-generated, hyper-parameterized
SystemVerilog:

1. `string` type in the simulation disassembly tracer
2. a `final` block (sim-only)
3. `$finish` used outside an `initial` block (sv2v-lowered assertions)
4. `$bits(type(...))` type-query operator
5. `AST_AUTOWIRE` sizing failure in the CV-X-IF example coprocessor's mega-expression
6. `AST_AUTOWIRE` sizing failure in the MMU/TLB's parameterized index expressions
7. a paramod generate-block port tied to constants in the FPU (`fpnew`)

Each is individually patchable, but they cascade; a clean whole-core open-source synthesis
would take substantial per-construct surgery — and would still not be authoritative.

> **Conclusion (a real finding, not just a nuisance):** **CVA6 is not friendly to the
> open-source synthesis flow.** It is developed and validated on **Xilinx/Vivado**, and that
> is by far the most trodden path. This has direct consequences for board choice (§5) and
> corroborates the Gowin tooling finding (§4).

## 4. Finding C — open-source tooling does not cover the GW5AST-138

The open-source Gowin flow is **yosys (`synth_gowin`) → nextpnr-himbaechel-gowin → Project
Apicula (`gowin_pack`) → openFPGALoader**. Apicula's device coverage, as of this study
(Aug 2026):

- **Production-ready:** older/smaller **LittleBee (GW1N) and GW2A** families (Tang Nano
  9K/20K, Tang Primer 20K).
- **GW5A / Arora-V:** **experimental, actively reverse-engineered** (clock routing, ALU,
  memory, DCS/OSC have landed) but incomplete, and focused on the **small** GW5A parts.
- **GW5AST-LV138 (the Tang Mega 138K Pro's device):** one of the **largest** Arora-V parts,
  with hardened RISC-V/DDR3/SerDes — **not usably supported**. A design as large as CVA6
  needs mature, complete device support that does not exist open-source for this part.

**Consequences:**

- For the Tang Mega 138K Pro, **Gowin EDA is required** to produce a bitstream. (`openFPGALoader`
  can still *program* a Gowin-produced `.fs`, and Verilator/yosys remain useful for
  simulation and estimates — but not bitstream generation.)
- Gowin EDA runs **synthesis + place-and-route + timing in software with no board attached**
  — so exact fit/Fmax for GW5AST-138 is answerable **pre-purchase**, for the price of a free
  Gowin EDA download.
- ✅ **RESOLVED — GO (2026-08-25):** the obtained **NODELOCK license synthesizes AND
  place-and-routes** `GW5AST-LV138FPG676AC1/I0` (the Tang Mega part). Verified end-to-end in the
  reproducible feasibility VM — `set_device` + `run syn` + `run pnr` all pass and a bitstream is
  produced (blinky probe: 26/138,240 LUT, 26/139,140 FF). See
  **[docs/gowin-microvm.md](./gowin-microvm.md)** (`nix run .#gowin-vm` → Tier-1 gate). The board
  is therefore a viable target on licensing grounds; for the CVA6 capacity/fit question see §5
  (Tier-2, now **measured**).
  - ⚠️ **Correction (2026-09-07): this GO needs the COMMERCIAL IDE.** An earlier
    wording of this bullet said the *Education* edition did it "despite Sipeed listing
    the commercial IDE". The license is indeed NODELOCK/STD, but the IDE edition is a
    separate axis, and **Sipeed was right**: Gowin EDA **1.9.11.03 Education**'s
    `data/device/device_info.csv` lists only `GW5AST-LV138PG484AC1/I0` — the 484-pin
    **non-Pro** package — and no `FPG676` order code at all, so `set_device` for the
    Tang Mega Pro part cannot resolve. (It does ship the package pin data at
    `data/device/GW5AST-138B/FCPBGA676A.json`; it is the order-code *index* that is
    missing.) Commercial **1.9.12.03** carries it as row `gw5ast138b-007`. Both
    editions are packaged as store paths in
    [`nix/gowin-eda.nix`](../nix/gowin-eda.nix); use `.#gowin-eda`. This does not
    change the GO — only which download it depends on.

Sources: [Project Apicula](https://github.com/yosyshq/apicula) ·
[GW5A support issue #204](https://github.com/YosysHQ/apicula/issues/204) ·
[Apicula supported boards](https://github.com/YosysHQ/apicula/wiki/Nextpnr%E2%80%90Himbaechel-Gowin) ·
[Arora V family](https://www.gowinsemi.com/en/product/detail/60/)

## 5. Finding D — CVA6 capacity estimate (from published data)

Since the direct synthesis did not converge (§3), we bound CVA6's size from its **published
Xilinx FPGA utilization** and convert to LUT4-equivalent (LUT6→LUT4 typically inflates
~1.4–1.8×, since a 6-input LUT packs more logic than a 4-input one):

| Config | Est. LUT6 (Xilinx, core+caches) | Est. LUT4-equiv | Fit on GW5AST-138 (138,240 LUT4)? |
| --- | --- | --- | --- |
| `cv64a6_imafdc` (RV64GC **with FPU**) | ~80–110K | **~120–180K** | **At the edge or over** — little room for parser + buffer, none for DDR/SFP+ later |
| `cv64a6_imac` (no FPU) | ~60–80K | **~90–130K** | **Fits with headroom** — the parser (~6K) drops in comfortably |

The **FPU is the swing factor** (~20–30K LUT6 ≈ 30–50K LUT4), and **the parser does not need
it**. So a leaner core is a perfectly reasonable prototype target.

> These are estimates with real uncertainty, but the **qualitative** conclusion is robust:
> full RV64GC-with-FPU is tight-to-over on a 138K-LUT4 part; a no-FPU config fits comfortably.

### 5a. Tier-2 measured (2026-08-25) — GowinSynthesis on the real part

Beyond the estimate: the feasibility VM (§4, [gowin-microvm.md](./gowin-microvm.md)) ran the
**actual** `cv64a6_imafdc` core through GowinSynthesis targeting `GW5AST-LV138FPG676AC1/I0`. Two
fixes were needed before it would elaborate — the raw sv2v `flat.v` trips Gowin's Verilog dialect
on `$bits` (use the cleaned `flat_synth.v`), and sv2v leaves four config-struct constants as
illegal dotted accesses (`CVA6Cfg.{ASID_WIDTH,VMID_WIDTH,VpnLen,PtLevels}`; substitute
`16/14/27/3`). With those, **the full core elaborates and synthesizes** (netlist conversion →
optimization → inference → tech-mapping, ≈4 h single-threaded) — already a step past this section's
"did not converge." It then stops at a hard resource error:

> `ERROR (RP0001): The number(558387) of DFF(DL) ... exceeds the resource limit(139140)` — i.e.
> **~558K flip-flops vs 139,140 available (~4× over)**, register-bound.

**The FF number is a flatten-flow artifact — and quantifying it flips the verdict to "fits."**
The log shows **zero BSRAM inferred**, and GowinSynthesis maps one un-inferred memory bit to one
DFF, so the 558,387 decomposes cleanly against this config's cache geometry (I$ 16 KiB/4-way,
D$ 32 KiB/8-way, 128 b lines, PLEN 56):

| Quantity | Value |
| --- | --- |
| DFF demand (reported) | 558,387 |
| I$/D$ data + tags | ~534,500 bits |
| + TLB / branch-predictor / regfile | ~9,000 bits |
| **On-chip memory subtotal** | **~543,000 bits** |
| **Logic (non-memory) FF** = 558,387 − memory | **~15,000 FF** (~11% of 138,240) |
| Same memory in **BSRAM** | 543K / 6,120 Kbit = **8.7%** of block RAM |

So the "~4× over" is ~97% **cache/tag arrays mapped to flip-flops** because the monolithic sv2v
flatten defeats BSRAM inference. Mapped correctly, the memories use **< 9%** of the device's
6.12 Mbit block RAM and the real sequential logic is only ~15K FF. **`cv64a6_imafdc` fits on the
GW5AST-138 with proper BRAM mapping** — comfortably on registers/memory; the one axis not directly
measured is logic-LUT (the §5 estimate, inflated by counting caches as logic, loosely bounds it
≲138K). The overflow is **memory-mapping, not FPU** (a no-FPU `imac` overflows the same way); the
real remaining work is **BRAM inference** — CVA6's SRAM macros onto Gowin BSRAM — which is exactly
the Tang Mega's "highest integration effort" cost (§6, board #5). The low-risk path to a *turnkey*
CVA6 fit remains a Xilinx board with the official CVA6 FPGA reference design.

## 6. Recommendations — top 5 FPGAs for this project

Deciding factors, in priority order: **(1)** toolchain maturity for *CVA6* (Xilinx-first),
**(2)** capacity for CVA6 + parser + headroom, **(3)** a real Ethernet MAC/PHY + DDR for the
parsing endgame, **(4)** openness / cost.

| # | Board / FPGA | Logic | Ethernet / DDR | Toolchain | CVA6 fit | Key trade-off |
| --- | --- | --- | --- | --- | --- | --- |
| **1** | **Digilent Genesys 2** — Kintex-7 XC7K325T | ~203K LUT6 | **GbE + SFP+**, DDR3 | Vivado (license needed for 325T; academic pricing) | Full RV64GC+FPU, huge headroom | *The* official CVA6 FPGA target — SoC/DDR/MAC already wired. **Lowest-risk path.** Cost + paid Vivado. |
| **2** | **Artix-7 XC7A200T** — Alinx AX7203 / QMTECH (or Nexys Video) | ~134K LUT6 | GbE + DDR3 (Alinx/QMTECH; Nexys Video has no RJ45) | **Vivado WebPACK — free** | Full CVA6 (tight-ish w/ FPU, comfortable trimmed) | **Best value + free vendor tools.** Port the CVA6 SoC from Genesys2 (Xilinx→Xilinx, moderate). ~$250–350. |
| **3** | **Xilinx Zynq UltraScale+** — Kria KV260 / ZCU104 | Large | Hardened GbE, DDR4 | Vivado | Full CVA6 + room | Hardened **ARM + Linux** to drive/benchmark the parser realistically. Pricier. |
| **4** | **Lattice ECP5** — ULX3S-85F (logic) / Colorlight 5A-75 (ethernet) | ~84K LUT4 | Colorlight: **2× GbE PHY**, cheap; ULX3S: none built-in | **Fully open — yosys + nextpnr + Trellis, no vendor software** | **Trimmed CVA6 (no FPU) or Ibex** + parser | The **100%-open** option. Cost: smaller core, no full RV64GC. Colorlight ~$20–40. |
| **5** | **Sipeed Tang Mega 138K Pro** — Gowin GW5AST-138 | 138K LUT4 | **2× SFP+ (10GbE)**, DDR3, PCIe | Gowin EDA required (open flow immature for GW5A) | Trimmed likely; full is tight | **Best raw I/O for the 10GbE endgame** and cheap — but **highest integration effort** (no CVA6 ref design, Gowin-only, SV-compat risk). |

### Guidance by priority

- **Least pain / most likely to just work → Genesys 2 (#1).** CVA6's home board; DDR + GbE +
  SFP+ done. Buy if academic Vivado is acceptable.
- **Best value with free tools → Artix-7 A200T (#2).** Free Vivado, fits CVA6, 1GbE + DDR3,
  ~⅓ the price; a little Xilinx-to-Xilinx porting.
- **Avoiding vendor software is the priority → ECP5 (#4).** Fully open, but commit to a
  leaner core (no-FPU CVA6 or Ibex) — which §5 shows is a reasonable prototype.
- **10GbE line-rate parsing is the whole point / you enjoy the integration → Tang Mega (#5).**
  Great I/O, cheap; expect to build the CVA6 SoC integration yourself under Gowin EDA.

### Documented alternative — Alinx **AX7325B** (Kintex-7 XC7K325T, 4× SFP+ + 40G QSFP+)

> **Why this is here:** the Tang Mega 138K Pro is ordered (§ Which SKU), but its cost is the
> **Gowin integration effort** (no CVA6 reference design; hand-map SRAM macros to BSRAM — §5a). If
> that proves painful, this is the **Xilinx fallback that fixes exactly that** while keeping (in fact
> exceeding) the 10 GbE I/O. It's the same FPGA as board #1 (Genesys 2 = the *official* CVA6 target),
> so **CVA6 bring-up is turnkey**, but with far more optical I/O. Effectively "#1 with 10G/40G." Recorded
> now so a mid-project pivot is a lookup, not a re-investigation.

Confirmed specs ([alinx.com/…/AX7325B](https://en.alinx.com/Product/FPGA-Development-Boards/Kintex-7/AX7325B.html)):

| Item | AX7325B |
| --- | --- |
| FPGA | AMD/Xilinx **Kintex-7 XC7K325T** (28 nm) — ~203K LUT6, ~16 Mbit BRAM, 16 GTX transceivers |
| **Optical I/O** | **4× SFP+ @ 10 Gbps** + **1× QSFP+ @ 40 Gbps** (= 80 Gbps aggregate) |
| Memory | 2 GB (64-bit) DDR3 on-board **+ 1× SODIMM up to 8 GB DDR3**; 16 MB QSPI flash |
| Host / expansion | **PCIe Gen2 ×8** (card edge), 1× FMC LPC, 40-pin expansion, MicroSD |
| Misc | USB-UART, LM75 temp sensor, LEDs/keys, 12 V single supply, 221×120 mm PCIe-card form factor |
| CVA6 fit | Full RV64GC+FPU with large headroom (turnkey — same part as Genesys 2 / `corev_apu/fpga`) |

**Buy caveats (the real gotchas — not capacity):**
- **Vivado license.** XC7K325T is **above free Vivado WebPACK** (which stops at Kintex-7 **160T**), so
  it needs a **paid Vivado Standard** license — or the **AMD University Program** if eligible. Same
  license reality as the Genesys 2.
- **Speed grade.** Confirm a **-2** part on the Product Selection Matrix so the GTX transceivers reach
  10.3125 Gbps (needed for 10G/40G line rate; -1 is marginal).
- **Throughput expectation.** The 10G/40G is *interface* capability. A single CVA6 (~100 MHz on K7)
  cannot parse **64 B packets at 10G line rate** (14.88 Mpps); it's comfortable at **larger packet
  sizes** (10G @ 1500 B ≈ 820 Kpps). The board's value is a **real line-rate datapath** (hardware
  MAC/PCS-PMA → parser) to *measure the parser speedup against wire rate* — not a promise the scalar
  core saturates 40G. Alinx also sells a 10G Ethernet MAC + TCP/IP IP core for the datapath below the
  parser.

## 7. Decision framework

```
              Do you need full RV64GC + FPU?
                        |
          +-------------+-------------+
          | yes                       | no (parser needs no FPU)
          v                           v
   Big Xilinx (Genesys 2         Fits ~90–130K LUT4:
   / A200T / Zynq US+)           many options open up
          |                           |
   Vendor tools OK? --- no ---> ECP5 (open) w/ trimmed CVA6 or Ibex
          | yes                       |
          v                           v
   Genesys 2 (#1) / A200T (#2)   ECP5 (#4), or Tang Mega (#5)
                                 if 10GbE endgame + Gowin OK
```

**Regardless of board, the parser is portable** — the width-parameterized unit drops onto
CVA6 *or* Ibex — so the board decision is really "how much host core do I want, and how
open/cheap/wired-for-Ethernet."

## 8. Next steps (all pre-purchase, no board required)

1. **Tang Mega, if still a candidate:** Gowin EDA is installed; the check is now automated in a
   reproducible feasibility VM — see **[gowin-microvm.md](gowin-microvm.md)**. (a) `nix run
   .#gowin-vm` → Tier-1 gate confirms whether `GW5AST-LV138FPG676A` synthesizes+routes under the
   Education/NODELOCK license (§4); (b) if GO, Tier-2 runs a software-only Gowin synth of
   `cv64a6_imac` → exact utilization + Fmax. That is the real go/no-go, and it costs nothing but
   compute.
2. **Xilinx path:** the CVA6 `corev_apu/fpga` reference design targets Genesys 2 directly; a
   free-Vivado A200T build is a modest port. This is the lowest-risk route to a working
   CVA6 + parser + 1GbE demo.
3. Whichever board: build **stock CVA6 first** (baseline), then add the parser unit, then the
   MAC→buffer path — per [phase-8-fpga.md](phase-8-fpga.md) §8.4.

## Appendix — reproducing the estimates

```bash
NP=github:NixOS/nixpkgs/867dcbc30bafe3c862ef88620f2e7a109d7d3be5
# parser datapath, LUT4 mapping:
nix shell "$NP#haskellPackages.sv2v" -c sv2v -I rtl --write=parser_dp.v \
  rtl/parser_pkg.sv rtl/parser_cam.sv rtl/parser_pktbuf.sv rtl/parser_decode.sv rtl/parser_execute.sv
nix shell "$NP#yosys" -c yosys -p \
  "read_verilog parser_dp.v; synth -lut 4 -top parser_execute; stat"
```

**Caveats:** generic yosys LUT4 mapping does not infer BRAM/DSP (memory shows as
flops/LUTs); standalone module synthesis can infer latches that inflate combinational-only
blocks; the CVA6 whole-core synthesis does **not** complete on this flow (§3). Treat all
CVA6 numbers as published-data estimates (§5), to be confirmed by the target vendor's tool.
