randomizedcoder/rtl-fun/docs/phase-7-toolchain.md

# Phase 7 — Toolchain support

← [Phase 6](phase-6-verification.md) · [Docs index](README.md) · [Phase 8 »](phase-8-fpga.md)

## Objective

Make the parser instructions usable from real code, in increasing order of
investment: raw `.insn` → intrinsics → assembler → compiler → ISA simulators. Do
the cheap thing first; only add heavyweight tool support once the ISA has settled.

> **Status: 🔵 In progress — the exit criterion is met** (the C slice runs on Spike **and**
> QEMU == the golden model); the remaining work is the deferred tail (LLVM MC + GCC builtins,
> full upstream riscv-tests, riscv-dv, the non-slice ISA groups, and the prose-freeze items).
> - **Level 1 (§7.2) — done:** the `.insn` + intrinsics header
>   [`toolchain/parser_insn.h`](../toolchain/parser_insn.h) emits every slice
>   instruction from the Phase-3 table.
> - **Level 4 (§7.5) — standalone Spike (Stage 2) + C-intrinsics slice (Stage 3) + QEMU:**
>   the parser custom extension (Phase-2 semantics, reusing `libparsermodel`,
>   `nix/spike-tandem/parser_ext.cc`) was first built libraries-only as the
>   [Phase-6](phase-6-verification.md) RVFI-vs-Spike lock-step oracle (`spike-tandem`). Stage 2
>   adds a **runnable** standalone `spike` ([`nix/spike-parser.nix`](../nix/spike-parser.nix),
>   `install-exes`) with the same extension + the `0x5000_0000` packet MMIO device
>   (`nix run .#parser-spike`). Stage 3 then **authors the slice in C** with the generated
>   intrinsics ([`tests/cva6-parser/parser_slice.c`](../tests/cva6-parser/parser_slice.c)):
>   `nix run .#parser-spike-slice` compiles it, asserts its 53 words are byte-identical to the
>   model ROM, and runs it on the standalone Spike over the 22-case corpus == model. The **QEMU
>   leg** then teaches a patched `qemu-system-riscv64` the same ops + device
>   ([`nix/qemu-parser.nix`](../nix/qemu-parser.nix)) and runs the identical ELFs and C slice on
>   it (`nix run .#parser-qemu` / `.#parser-qemu-slice`, both 22/0 == model). With Spike **and**
>   QEMU green, **the exit criterion is met** ✅.
> - **Level 2 (§7.3) — done:** a parser-patched `riscv64-none-elf` binutils
>   ([`nix/parser-binutils.nix`](../nix/parser-binutils.nix)) assembles the `prs.*`
>   mnemonics and `objdump` disassembles them — Hybrid operand syntax **plus** the
>   additive Stage-1.5 prose sugar (`pcurptr+N`, `paccum[i]`, `value:mask`; see §7.3).
>   `nix run .#parser-asm-test` assembles every mnemonic (both syntaxes) and checks each
>   word equals the generated/model golden, that objdump renders it readably, **and** that
>   the disassembly reassembles to the same encodings (round-trip).
> - **In progress — the *prose-freeze* follow-on:** the notation items that needed an
>   ISA-notation decision (not just code) are now **frozen** in
>   [phase-1-isa-spec.md](phase-1-isa-spec.md) §1.12: the load `E` → `.be` (E=1 = big-endian),
>   `.stp` = the group S bit, `mult:min` (log2), the `.stop`/`.stopnode`/`.stopsub`/`.fail`
>   (cmp `Er`) + CAM `Miss` + `.min` (length `D`) suffixes, store/storeimm `pmeta+N`, required
>   destination pseudo-registers, and the `prs.lenset{,min,add}` / `prs.cmpi{,ne}` aliases —
>   being implemented as suffix-variant + alias rows in `tools/parser-gen` + the binutils patch
>   (bits unchanged; §7.3). Then LLVM MC + intrinsics/builtins and GCC
>   builtins (L3), and the
>   heavyweight random-instruction checks — full upstream riscv-tests and riscv-dv (the
>   latter blocked on a commercial UVM simulator; the Phase-6 Stage-2 campaign randomizes
>   only the *packet* axis).

## Inputs / prerequisites

- Phase 3 encoding table (`isa/parser-opcodes.*`) — the single source of bits.
- Phase 2 golden model (semantics the simulators must match).

## Design detail

### 7.1 Staging — cheapest first

```
 .insn / inline-asm  ──►  intrinsics header  ──►  binutils (as/objdump)
        │                                                  │
        └── enough to write & run the parser  ─────────────┘
                                                           ▼
                              LLVM MC + intrinsics/builtins ──► Spike ──► QEMU
```

Rule of thumb from the blog: **don't touch GCC/LLVM until the instruction set is
settling.** The `.insn` + intrinsics path (already started in Phase 3 §3.4) is
enough to write real parsers and benchmark them.

### 7.2 Level 1 — `.insn` + intrinsics (do now)

`toolchain/parser_insn.h`: one inline-asm wrapper per instruction, emitting the
exact encoding from the Phase-3 table:

```c
static inline uint64_t prs_load_h(uint32_t disp) {
    uint64_t r;
    asm volatile(".insn i CUSTOM_0, 0x1, %0, x0, %1" : "=r"(r) : "I"(disp));
    return r;
}
/* prs_cam_h_stp, prs_lensetmin_n, prs_cmpi_n_fail, prs_store_*, ... */
```

With these, the Phase-0 slice can be written as ordinary C and run once a
simulator understands the encodings (7.5).

### 7.3 Level 2 — binutils ✅

- **Done.** [`nix/parser-binutils.nix`](../nix/parser-binutils.nix) patches nixpkgs
  `riscv64-none-elf` binutils 2.46 to add the parser instructions to GNU **as**
  (mnemonics → encodings) and **objdump** (disassembly). The opcode-table rows are
  **generated** by `tools/parser-gen` into
  [`toolchain/generated/parser-opc-gas.inc`](../toolchain/generated/parser-opc-gas.inc)
  and pasted into the patch; immediates ride binutils' stock `XtuN@S` bitfield operand,
  so the hand-written operand classes are just the parser p-register `Xpr` (Cpreg[28:24],
  names from the yaml `p_registers`) and the three Stage-1.5 prose operands
  (`Xpo`/`Xpa`/`Xpm`, below).
- **Hybrid operand syntax** (the increment that landed): real register operands where they
  exist + a dotted size suffix, e.g.

  ```asm
  prs.load.h    1, 12          ; Sz via .h suffix; E=1, Offset=12
  prs.store.b   0, 8           ; Pos=0, Offset=8
  prs.mv.p.x    pnext, a0      ; write GPR a0 -> parser p-register pnext
  prs.mv.x.p    a1, paccum     ; read parser p-register paccum -> GPR a1
  ```

  Objdump round-trips the register names (`pnext`, `paccum`, …). This replaces `.insn`
  blobs for the assemblable slice.
- **Prose operand sugar (Stage 1.5, additive) ✅:** on top of Hybrid, the lossless subset
  of the docs' prose that maps cleanly and reversibly to encoder bits. Three forms, driven
  by a `prose:` map in the yaml and emitted as extra opcode rows by `tools/parser-gen`:

  ```asm
  prs.load.h    1, pcurptr+12         ; Offset via pcurptr+N (bare `pcurptr` == 0)
  prs.store.b   paccum[0], 8          ; Pos via paccum[i] sub-register index
  prs.cmpib     1, paccum[0], 0x40:0xF0  ; Value:Mask as one value:mask pair
  ```

  Each sugared mnemonic gets a prose row **before** its Hybrid row (identical match/mask):
  gas tries the prose row first, so `objdump` prints the sugar; the Hybrid form still
  assembles because gas falls through when the `pcurptr`/`paccum` keyword is absent. Both
  syntaxes hit the exact same word, and the disassembly reassembles (round-trip). The new
  operand classes (`XpoN@S` = `pcurptr+N`, `XpaN@S` = `paccum[i]`, `Xpm` = `value:mask`)
  live in the patch's `Xp` vendor namespace next to `Xpr`.
- **Prose-freeze (pinned; implementing):** the notation items that needed an ISA-notation
  *decision*, not just code, are now **frozen** in
  [phase-1-isa-spec.md](phase-1-isa-spec.md) §1.12 "Assembly notation (frozen)": the load
  `E`-bit → `.be` suffix (E=1 = big-endian; the model is the source of truth and the polarity
  prose was corrected to it); `.stp` = the group S bit on cam/camnext + the length family
  (distinct from the standalone `prs.stp` `next`-group word — same effect, different encoding);
  `mult:min` (assembler sets `Shift=log2(mult)`); the `.stop`/`.stopnode`/`.stopsub`/`.fail`
  (cmp `Er`), CAM `Miss`, and `.min` (length `D`) suffixes; store/storeimm `pmeta+N` (a
  metadata-frame displacement, distinct from load's packet `pcurptr+N`); required destination
  pseudo-register decoration (`paccum`/`pnext`/`pcurhdr`/`pdathdr`), where for CAM the
  `paccum`/`pnext` destination **selects** the `D` bit — a single `prs.cam` mnemonic (no separate
  `prs.camnext`), matching the patent's disassembly; and the
  `prs.lenset{,min,add}` / `prs.cmpi{,ne}` mnemonic aliases. Unlike Stage-1.5 these fold bits
  into the mnemonic/aliases (not pure operand sugar), so they extend `tools/parser-gen` with
  suffix-variant + alias rows; every spelling still encodes to identical bits and round-trips
  through objdump.

  Landing incrementally: the **dotted-suffix bit-folding** mechanism (load `.be`, cam/length
  `.stp`, and the cmp `Er` `.stop`/`.stopnode`/`.stopsub`/`.fail` suffixes) is **✅ implemented** —
  `tools/parser-gen` cross-products each folded field with the `Sz` suffix (56 → 100 gas rows),
  the intrinsics keep the folded field as a parameter (bits unchanged), and `parser-asm-test`
  round-trips all spellings while `parser-spike-slice`/`parser-qemu-slice` stay byte-identical
  (53 words) and 22/0.

  **Destination decoration — the single `prs.cam`** is **✅ implemented**: a `dest:` binding folds
  the CAM `D` bit into a leading destination pseudo-register (`paccum` ⇒ `D`=0 Accum, `pnext` ⇒
  `D`=1 Next), rendered by the new `Xpc` binutils operand class and printed by objdump — so there is
  a single `prs.cam` mnemonic and no `prs.camnext` (matching the patent). The generated `prs_camnext`
  intrinsic is subsumed by `prs_cam`'s new leading `d` parameter; `parser_slice.c` and the vectors
  use `prs_cam(1, …)`; bits are unchanged (byte-parity holds).

  **`pmeta+N` store displacement** is **✅ implemented**: the store/storeimm `Offset` now takes the
  `pmeta+N` prose form (a new `metaptr` kind → the `Xpe` binutils operand), a base distinct from
  load's packet `pcurptr+N` because a store targets the metadata frame (`ps->meta`), not the packet.
  Bits unchanged (same `Offset` field).

  **Length-family notation** is **✅ implemented** — the coupled pieces land together so objdump
  reaches the frozen canonical `prs.lensetmin.n pcurhdr, paccum[1], 4:20` in one step: (a) the
  `prs.lenset` (`D`=0) / `prs.lensetmin` (`D`=1) mnemonic aliases fold `D` into the name, replacing
  `prs.lencur`; (b) a **cosmetic-fixed** `dest: { token: pcurhdr }` prints the required `pcurhdr`
  destination via the new `Xph` operand (consumes no bits — the length family always targets the
  current header, `F2`=0); (c) the `mult:min` operand (`Xpl`) sets `Shift`=log2(mult) (mult ∈
  {1,2,…,64}) and `Len`=min; and (d) `Shift`=7 (constant length) is spelled `prs.lensetconst` (a
  distinct mnemonic pinning `Shift`=7/`Pos`=0), ordered before `prs.lenset` so objdump prefers it.
  The `prs_lencur` intrinsic splits into `prs_lenset`/`prs_lensetmin`/`prs_lensetconst` (names track
  the canonical mnemonics); bits unchanged (byte-parity holds).

  **Load destination decoration** is **✅ implemented** — a **cosmetic-fixed** `dest: { token: paccum }`
  prints the required leading `paccum` on every `prs.load` via the new `Xpp` operand (consumes no bits —
  a load always targets the accumulator), completing the §1.12 rule that *every* op names its
  destination. Mirrors the length family's `Xph`/`pcurhdr`; `prs_load`'s intrinsic signature is
  unchanged (bits identical, byte-parity holds). This closes the prose-freeze notation arc.

  Out of the encoder's scope (no model/encoder, like the TLV loops), so **not** frozen into gas:
  `PLENDATA`/`PLENDATABND` (the `pdathdr`/`pdatabnd` `F2`=1/2 targets), any `lensetadd`, and the
  `prs.cmpi{,ne}` compare-with-size aliases.

### 7.4 Level 3 — LLVM / GCC

- **LLVM MC** layer first (assemble/disassemble), then **intrinsics/builtins** so
  the parser unit is reachable from Clang without inline asm.
- GCC builtins optional/parallel.
- Only worthwhile once encodings are frozen — churn here is expensive. (The notation
  freeze is now complete, so this leg is unblocked.)

  **LLVM MC — L1 (immediate-only ops) ✅.** The LLVM twin of the binutils leg (§7.3),
  generated from the same `isa/parser-opcodes.yaml`. `tools/parser-gen`'s `emit_llvm`
  writes a TableGen fragment ([`toolchain/generated/parser-llvm.td`](../toolchain/generated/parser-llvm.td));
  [`nix/parser-llvm.nix`](../nix/parser-llvm.nix) patches the in-tree RISC-V target
  (`RISCVInstrInfoXparser.td`, included from `RISCVInstrInfo.td`) with it, scoped to
  `LLVM_TARGETS_TO_BUILD=RISCV` to keep the from-source rebuild small. The ops live in the
  **default RISCV decoder namespace with no predicate** — always assemblable, the analogue
  of the binutils `INSN_CLASS_I` rows (custom-0 `0x0b` / custom-3 `0x7b` are unused by the
  base ISA, so there is no matcher/decoder conflict and no `-mattr` gate; assembly **and**
  disassembly work with zero custom C++). `nix run .#parser-llvm-mc-test`
  ([`scripts/parser-llvm-mc-test.sh`](../scripts/parser-llvm-mc-test.sh)) drives the SAME
  `verif/gen/parser_asm_vectors.c` vectors through `llvm-mc`/`llvm-objdump`: it classifies
  each line (assembled → its word MUST equal the golden; rejected → logged as DEFERRED,
  never silently dropped) and round-trips the disassembly. L1 covers the **immediate-only**
  custom-0 ops (`store`/`storeimm`/`cmpib`/`cmpneib`/`nextnode`/`setcode`/`stp`) — every
  operand is a stock `uimmN`, so no custom operand class is needed (10 vector lines, 0
  mismatches). Bit-identical to the model/binutils (same `match | suffix-delta` word).

  **LLVM MC — L2 (custom-3 moves) ✅.** `emit_llvm` now also emits a `PRReg`
  **`RegisterClass`** (the Cpreg[28:24] p-register file, `p0`..`p31`) whose ABI-style
  aliases — `paccum`, `pnext`, `pcurhdr`, … — are single-sourced from the new
  `p_registers.*.alias` yaml field and ride RISC-V's existing `ABIRegAltName` index, so
  `llvm-mc` accepts both `p15` and `paccum` and `llvm-objdump` prints the alias. With that,
  the five custom-3 moves (`prs.mv.x.p`, `prs.mv.p.x`, `prs.ld.immed`, `prs.cam.read`,
  `prs.array.read`) assemble and encode **entirely from TableGen** — register-class
  membership and `HWEncoding` are automatic, and the stock `RISCVAsmParser::parseOperand`
  already falls back to generic register parsing (`matchRegisterNameHelper`), so **no
  matcher/parser/printer C++** is needed. The one exception is the disassembler: the
  generated decoder references `Decode<RC>RegisterClass`, so the patch adds a **6-line
  `DecodePRRegRegisterClass`** to `RISCVDisassembler.cpp` (mirroring `DecodeGPRRegisterClass`
  and the binutils leg's hand-written disasm). 15 vector lines now assemble, 0 mismatches,
  round-trip identical. Bit-identical to the model/binutils.

  **LLVM MC — L3a (destination decoration) ✅.** The custom operand family begins with the
  leading destination pseudo-register on the custom-0 load/cam/length ops. `emit_llvm` emits
  three `AsmOperandClass`es — `accumdest` (`paccum` on load), `curhdrdest` (`pcurhdr` on
  length), `camdest` (`paccum`/`pnext` on cam) — each a small immediate **riding a real
  discriminator bit** (load/cam D[30], length F2[20:19]) so `llvm-objdump` can reconstruct +
  print it (LLVM decodes printed operands from real bits — a no-bits operand is silently
  dropped by the decoder). Because the keywords collide with the L2 p-register alt-names, the
  patch adds custom `ParserMethod`s (`parseAccumDest`/`parseCamDest`/`parseCurHdrDest`) that
  consume the keyword before the generic register fallback — `parseOperand` tries the
  per-operand `MatchOperandParserImpl` first — plus matching `PrintMethod`s; encode/decode
  stay automatic (the dest is a plain immediate on a real field). yaml gained a `field:` on
  the cosmetic `dest` tokens naming the fixed bit they ride. 28 vector lines now assemble
  (the 13 dest-decorated load/cam/length Hybrid forms), 0 mismatches, round-trip identical.
  Bit-identical to the model/binutils.

  **LLVM MC — L3b (prose-sugar operands) ✅.** The rest of the custom operand family, mirroring
  binutils' `Xpo`/`Xpe`/`Xpa`/`Xpm`/`Xpl`: `pcurptr+N` (load Offset), `pmeta+N` (store/storeimm
  metadata Offset), `paccum[i]` (Pos), `value:mask` (cmp Value+Mask), `mult:min` (length
  Shift=log2(mult)+Len). `emit_llvm` swaps each prose field's `uimm` for a custom
  `AsmOperandClass` (predicates reuse RISC-V's stock `isUImmN`); the C++ adds five
  `ParserMethod`s and three `PrintMethod`s. Each op keeps **one def** that assembles *both* the
  prose and the Hybrid spelling — the parser dispatches the `ParserMethod` before the generic
  immediate path, and the matcher keys only on the final operand vector. The two field-combining
  forms (`value:mask`, `mult:min`) use a **multi-push** `ParserMethod` (one parse call emits both
  operands; on a bare value it emits one and the next slot is parsed normally), so no second def
  and no decoder conflict — the AsmString stays plain-comma (a glued `$a:$b` is a TableGen error),
  which means the combining forms print positionally while the single-field forms print the
  canonical prose keyword; every form round-trips by word. All **38** vector lines now assemble
  (0 deferred), 0 mismatches, round-trip identical — full binutils parity for the MC layer.
  Bit-identical to the model/binutils throughout (presentation-only).

  **Clang — C0 (build stood up) ✅.** The Clang leg (`nix/parser-clang.nix`) is a `clang`
  built against the parser-patched **libLLVM** (`clang-unwrapped.override { libllvm = <the L3
  llvm>; }`, RISCV-only, clang-tools-extra off). Clang's integrated assembler *is* the LLVM MC
  layer, so this Clang parses/encodes the `prs.*` mnemonics with no extra flags — inheriting the
  L1–L3b patch for free, with **no** clang source touched yet. `nix run .#parser-clang-check`
  proves it: (1) clang's integrated-as assembles a spread of `prs.*` to the exact golden words
  (`prs.load.h.be paccum, 12 → 0x2010600b`, …), and (2) the unchanged C slice (`parser_slice.c`,
  the `.insn` intrinsics path) compiles under clang with its 53-word `parse_prog` byte-identical
  to the model ROM (`enc.hex`). This de-risks the from-source Clang build before any codegen.

  **Clang — C1 (custom-0 builtins) ✅.** `emit_builtin` (tools/parser-gen) flattens every
  custom-0 assembly *variant* — the size/attribute-suffix cross-product crossed with the dest
  discriminator — into one `__builtin_riscv_prs_*` (**67** total, e.g. `prs_load_h_be`,
  `prs_cam_h_stp_pnext`, `prs_cmpib_stopsub`). It emits three artifacts
  (`toolchain/generated/parser-clang-builtins.{td,inc,tsv}`); the clang patch is a one-line
  `BuiltinsRISCV.td` include plus **one generic** table-driven arm each in `SemaRISCV.cpp`
  (immediate-range checks via `BuiltinConstantArgRange`) and `TargetBuiltins/RISCV.cpp` (lowering).
  Each builtin takes only the true operands as `_Constant` immediates and lowers to an
  operand-less `asm volatile("<prs.* mnemonic> $0, …")` with `i` operands — the immediates print
  as literals (no register, naked-safe like `PRS_EMIT`), and the mnemonic is assembled by the C0
  MC layer. NO IR intrinsics, NO ISel. `nix run .#parser-clang-builtins-test` compiles an all-zero
  call per builtin and checks each emits its exact golden word (67/0). Bit-identical to
  model/binutils/llvm-mc (presentation-only); `parser-gen-check` guards the generated files.

  **Clang — C2 (builtins slice on Spike) ✅.** The Phase-0 slice
  ([`tests/cva6-parser/parser_slice.c`](../tests/cva6-parser/parser_slice.c)) is now dual-path:
  under `-DPRS_USE_BUILTINS` it includes
  [`parser_builtins.h`](../tests/cva6-parser/parser_builtins.h), a shim whose macros redefine each
  raw-field `prs_*(...)` call to dispatch — at compile time, via `__builtin_choose_expr` on the
  constant size/E/dest/stp/er fields — to the matching mnemonic-form `__builtin_riscv_prs_*`
  variant, with `PRS_EMIT` becoming a pass-through (the builtin emits the instruction itself). The
  slice **body is unchanged**; only the include and the `naked` attribute switch on the flag (the
  builtins path can't be `naked` — a builtin is a call-expr, not an `__asm__` statement — but at
  `-O2` a pure immediate-only-builtin function emits no prologue, so `parse_prog` stays byte-exact).
  `nix run .#parser-clang-slice` compiles the slice through the patched Clang and reuses the
  `parser-spike.sh` runner (a `SLICE_CC`/`SLICE_CC_EXTRA` compiler hook — one body, no drift with
  the intrinsics `parser-spike-slice`): the **53-word `enc.hex` byte-parity guard** proves the
  builtins lowering == the intrinsics lowering == the golden model ROM, then the **22-case corpus**
  runs on the standalone Spike == the model. This is "the parser unit reachable from Clang without
  inline asm" (§7.4). Presentation-only; `parser-gen-check` and the other slice runners stay green.

  **Clang — C3 (custom-3 register-move builtins) ✅.** The last group reachable before only via
  inline `.insn` — the 4 register-operand moves `__builtin_riscv_prs_{mv_x_p,mv_p_x,cam_read,array_read}`
  — giving C programmers a first-class way to **read/write the parser p-registers from Clang**. Unlike
  the immediate-only C0 builtins, these carry real GPR operands: the p-register is a `_Constant` baked
  into the mnemonic as `p<N>`, the rd is an `=r` output (the read's return value), the rs is an `r`
  input. `emit_clang_moves_data` walks the same yaml `coprocessor` block; a SECOND generic CodeGen arm
  (`PARSER_BUILTIN_LOWER_REG`) handles them, leaving the C0 immediate arm byte-identical (no IR
  intrinsics / ISel). Verified two ways (`nix run .#parser-clang-moves`): a **table-driven masked
  encoding** check (`(word & mask) == fixed` over each move × a spread of p-registers — the fixed
  opcode/CoP/Func3/S/I/R bits + the selected p-register in Cpreg, masking the allocator-chosen rd/rs),
  and a **functional round-trip** (`parser_moves.c`: a builtins-only write→read over p15/p16/p11 —
  WAW, sign-extend, and a randomized 256-value property loop — self-checked on the standalone Spike).
  `prs.ld.immed` stays deferred (immediate split-field form, not yet frozen). The Clang leg is now
  complete (immediate C0 + register C3).

  This closes the Clang leg. The remaining items (optional GCC builtins, `prs.ld.immed`,
  and the heavyweight random-instruction sweeps) are follow-up work, not pending phase
  tasks — see [Follow-up / deferred work](#follow-up--deferred-work).

### 7.5 Level 4 — ISA simulators

- **Spike ✅ (standalone, Stage 2):** the parser instructions are a custom extension
  (`nix/spike-tandem/parser_ext.cc`) implementing the Phase-2 semantics by reusing the
  pure-C `libparsermodel`. [`nix/spike-parser.nix`](../nix/spike-parser.nix) builds a
  **runnable** `spike` from the vendored CVA6 tree (`install-exes`; the executables link
  the shared `yaml-cpp` — the one delta from the libraries-only `spike-tandem`), with the
  `0x5000_0000` packet MMIO device registered on the bus (the same `Simulation.cc` patch
  the tandem uses, since the `spike` main is that openhw `Simulation`). `nix run
  .#parser-spike` runs the ELFs directly (`spike --isa=rv64gc`; the parser extension is
  always-on via `Proc.cc`, so no `--extension` flag — passing it would double-register): a
  `parser_tandem.S` smoke then the 22-case packet corpus, each passing iff it self-checks
  == the golden model (HTIF `tohost=1` → exit 0). This is Spike as an **independent
  executable** check of the ISA, distinct from the Phase-6 `spike-tandem` oracle (left
  untouched).
- **Level 4 Spike — the slice is now written in C (Stage 3):** the Phase-0 slice is authored
  as ordinary C with the generated intrinsics
  ([`tests/cva6-parser/parser_slice.c`](../tests/cva6-parser/parser_slice.c): 53 `PRS_EMIT(
  prs_*(...))` calls, one per `pm_slice_program()` entry). `nix run .#parser-spike-slice`
  compiles it (-O2), asserts the 53 words are **byte-identical to the model ROM** (`enc.hex`),
  and runs it on the standalone Spike over the 22-case corpus == model. This **closes the Spike
  leg** of the exit criterion.
- **QEMU (RISC-V) ✅:** `nix build .#qemu-parser`
  ([`nix/qemu-parser.nix`](../nix/qemu-parser.nix)) patches nixpkgs `qemu` (11.0.3,
  restricted to `riscv64-softmmu`) to decode + execute the custom-0/custom-3 parser ops
  via TCG helpers ([`nix/qemu-parser/parser_helper.c`](../nix/qemu-parser/parser_helper.c),
  a port of the Spike `parser_ext.cc` reusing `libparsermodel` unchanged) and to map the
  `0x5000_0000` packet MMIO device ([`parser_mmio.c`](../nix/qemu-parser/parser_mmio.c)) on
  the `-M spike` machine — whose HTIF (`tohost=1` → exit 0) + DRAM@0x80000000 run the
  existing self-checking ELFs unmodified. Custom-3 (0x7b) aliases QEMU's RV128 doubleword ops,
  which are remapped to the unused custom-1 opcode (rv64 never uses RV128); on stock QEMU the
  ops trap illegal (a genuine extension). `nix run .#parser-qemu` runs the `parser_tandem.S`
  smoke + the **22-case corpus == model** on the patched `qemu-system-riscv64`, and `nix run
  .#parser-qemu-slice` compiles the C slice (byte-identical to the model ROM) and runs it
  **22/0 == model**. This **closes the QEMU leg** — the exit criterion is met on both
  simulators. (`-nographic` wires the guest console to stdin, so the runner gives QEMU
  `</dev/null` to avoid draining the per-case suite loop.)
- Both must match the golden model bit-for-bit (reuse the Phase-2 corpus).

### 7.6 Consistency guarantee

Everything that touches bits — model encoder/decoder, `.insn` header, binutils,
LLVM MC, Spike, QEMU — is **generated from or checked against `isa/parser-opcodes.*`**.
No hand-copied encodings.

> **Status: ✅ the codegen spine is real.** `tools/parser-gen` reads
> `isa/parser-opcodes.yaml` (the new `mnemonics:` block + the `groups:` bit-truth) and
> emits `toolchain/generated/`: the binutils opcode fragment (`parser-opc.inc`,
> match/mask + operand descriptors — consumed by the L2 binutils patch) and the
> `parser_intrinsics.h` word-builders. `nix run .#parser-gen-check` regenerates and
> proves (a) the committed artifacts are byte-stable and (b) the generated encoders
> equal the model's hand-written `encoding.c` + the golden constants
> (`prs_load_h(12)==0x2010600b`) — closing the yaml↔C drift the round-trip tests can't
> catch. Scope = the `pm_encode` custom-0 set + the custom-3 moves.

## Step-by-step tasks

1. ✅ Finalize the `.insn` + intrinsics for every instruction — generated,
   drift-checked `toolchain/generated/parser_intrinsics.h` (`PRS_EMIT` now emits a
   correctly-unsigned `.insn 4` word, exercised for real by the Stage-3 slice).
2. ✅ Rewrite the Phase-0 slice parser in C using the intrinsics —
   [`tests/cva6-parser/parser_slice.c`](../tests/cva6-parser/parser_slice.c),
   `nix run .#parser-spike-slice` (byte-identical to the model ROM, 22-case corpus ==
   model on the standalone Spike) **and** `nix run .#parser-qemu-slice` (same slice, 22/0
   == model on QEMU).
3. ✅ Add binutils as/objdump support (generated from the table) — Hybrid operand
   syntax + additive prose sugar (`pcurptr+N`, `paccum[i]`, `value:mask`); round-tripping
   `objdump`. `nix run .#parser-asm-test`. Prose-freeze items deferred (§7.3).
4. ✅ Add Spike custom-extension support; validate against the Phase-2 corpus —
   standalone `nix run .#parser-spike` (Stage 2) + the C slice on it (Stage 3).
5. ✅ Add QEMU modeling; validate against the corpus — patched `qemu-system-riscv64`
   ([`nix/qemu-parser.nix`](../nix/qemu-parser.nix)), `nix run .#parser-qemu` (asm corpus)
   + `nix run .#parser-qemu-slice` (C slice), both 22/0 == model.
6. (When frozen) add LLVM MC + intrinsics/builtins; optional GCC builtins.

## Deliverables / artifacts

- `toolchain/parser_insn.h` and a C implementation of the slice parser.
- binutils patch; Spike + QEMU models.
- (Later) LLVM/GCC support.

## Exit criteria

- ✅ **Met.** The slice parser, written in C with intrinsics, assembles and runs on Spike
  **and** QEMU with outputs matching the golden model. **Spike leg** (`nix run
  .#parser-spike-slice`) and **QEMU leg** (`nix run .#parser-qemu-slice`): the C slice is
  byte-identical to the model ROM (53 words == `enc.hex`) and runs the 22-case corpus == model
  on both simulators. The asm-corpus twins (`parser-spike` / `parser-qemu`) also pass 22/0.
- Disassembly is human-readable (binutils/objdump). ✅ (`nix run .#parser-asm-test`)

## Follow-up / deferred work

The exit criterion is **met** and every rung a C programmer needs to reach the parser
unit is built: `.insn` + intrinsics, binutils as/objdump, full-parity LLVM MC, a
first-class Clang builtin surface (immediate **C0** + register-move **C3**), and both
ISA simulators (Spike + QEMU). The phase stays **🔵** rather than flipping to ✅ because a
deliberately **deferred tail** remains — none of it on the critical path, each item either
optional or externally blocked:

| Item | Why deferred | What would unblock it |
| --- | --- | --- |
| **GCC builtins** | Optional. Clang already gives the full `__builtin_riscv_prs_*` surface; the staging rule was "don't touch GCC/LLVM until the ISA freezes." A GCC leg mirrors the Clang one (generated from the same `isa/parser-opcodes.yaml`). | A decision that GCC parity is worth the second from-source toolchain build. |
| **`prs.ld.immed`** | A **spec** decision, not code: its split two-5-bit-immediate spelling is not frozen (see §7.3 / the prose-freeze arc). | Freezing the imm11 syntax in the yaml/ISA notation; the generator + Clang arm already handle the register moves it sits beside. |
| **Full upstream riscv-tests (Verilator)** | The heavyweight **random-instruction** axis — a base-ISA conformance sweep, orthogonal to the parser extension the phase is about. The parser ops themselves are already lock-stepped against Spike in Phase 6. | Wiring the upstream riscv-tests ELFs through the Verilator matrix as a CI target. |
| **riscv-dv instruction-axis random** | **Externally blocked** — riscv-dv's generator depends on a commercial UVM simulator this project does not license. | An open-source UVM path, or accepting the constrained-random packet campaign (Phase 6) as the substitute. |
| **Non-slice ISA groups** | The arrays / counters / TLV-loop / lifecycle instruction families have no encoder in the model yet — they are beyond the vertical slice this project verifies end-to-end. | Extending `model/libparsermodel` + the yaml to those groups (a model/ISA effort, upstream of the toolchain). |

The **prose-freeze** follow-on that once lived here is **done** (every frozen §1.12
spelling assembles, disassembles to canonical prose, and round-trips bit-identically).

Because these are follow-up items rather than pending phase work, **Phase 8 (FPGA
bring-up) can proceed now** — it reaches hardware through `.insn` / inline-asm and the
runnable slice binary, and does **not** depend on the Clang/GCC builtin surface. See
[phase-8-fpga.md](phase-8-fpga.md) and the board bring-up plan in
[tang-mega-138k-pro-rtl-fun-plan.md](tang-mega-138k-pro-rtl-fun-plan.md).

## Open questions

- **Decision:** upstream-style patches vs. out-of-tree fork for binutils/LLVM/Spike?
- **TBD:** how much LLVM support is worth it pre-freeze (recommend: MC only).
- Register modeling in Spike/QEMU: dedicated parser regs vs. reserved integer subset
  (mirror the Phase-3/4 decision).

## References

`.insn` docs, riscv-gnu-toolchain, LLVM, Spike, QEMU. See [references.md](references.md).
