randomizedcoder/rtl-fun/docs/environment.md

# Environment & versions

Phase 0 deliverable: a reproducible record of the tools the project builds on.
Everything below is provided by the Nix flake (`nix develop`) — see
[nix.md](nix.md). Versions are pinned by [`flake.lock`](../flake.lock); this table
is the human-readable snapshot.

## Captured

- **Date:** 2026-08-14
- **nixpkgs:** `nixos-unstable`, pinned in `flake.lock` (rev of 2026-08-12)
- **Host:** Linux x86_64

## Tool versions (from `nix develop`)

| Tool | Version | Phase | Role |
|---|---|---:|---|
| Verilator | 5.050 (2026-07-01, rev v5.050) | 5/6 | SystemVerilog simulation |
| verible-verilog-format | v0.0-4023-gc1271a00 | 5 | SV formatter + lint |
| svlint | 0.9.5 | 5 | SV linter |
| Yosys | 0.67 | 5 | elaboration / synthesis sanity |
| GTKWave | 3.3.128 | 6 | waveform viewer |
| Spike | 1.1.1-dev | 7 | golden RISC-V ISA simulator |
| QEMU (riscv64) | 11.0.3 | 7 | functional emulation |
| Python | 3.13.15 | 2/6 | scripts + cocotb |
| cocotb | 2.0.1 | 6 | Python co-sim testbenches |
| scapy | 2.7.0 | 2 | packet-corpus generation |
| pytest | 9.1.1 | 6 | test runner |
| openFPGALoader | 1.1.1 | 8 | program the FPGA over USB-JTAG |
| Gowin EDA | 1.9.11.03 Education / 1.9.12.03 commercial | 8 | bitstream generation (in the microVM) |
| poppler-utils (pdftotext) | 26.06.0 | docs | patent PDF extraction |
| riscv64-none-elf-gcc | 15.3.0 | 0/7 | bare-metal RISC-V cross compiler |
| riscv64-none-elf-binutils | 2.46 | 0/7 | assembler / linker / nm / objdump |
| GCC (host) | 15.3.0 | — | golden C model + Verilator C++ |
| GNU Make | 4.4.1 | — | build driver |

## Base core

- **CVA6** (OpenHW Group), pinned to **v5.3.0**
  (commit `2ef1c1b1fca419354920c5487293bc605294904e`), fetched via Nix
  (`nix/cva6.nix`, `sha256-Z39Q3CAbgT1VUv83RcnNwbO2EP/HkUcxhOrQbfiOzbs=`) and
  exposed in the dev shell as `$CVA6_SRC`.
- Baseline build: `nix run .#cva6-baseline` (a `writeShellApplication`) assembles
  a unified `$RISCV` prefix (toolchain + Spike libs/headers + yaml-cpp) and runs
  `make verilate`, producing `build/cva6/work-ver/Variane_testharness`.

## Known follow-ups

- **Gowin EDA is not in `nix develop`.** It is proprietary and node-locked, so it
  is packaged separately (`nix build .#gowin-eda-edu` / `.#gowin-eda`, from
  `nix/gowin-eda.nix`) and runs inside the microVM, not the dev shell. Which of the
  two editions the GW5AST-138 flow actually needs is still **TBD** — see
  [fpga-bringup-tang-mega-138k-pro.md](fpga-bringup-tang-mega-138k-pro.md).

- **Python pin.** `nix/packages.nix` pins `python313` only because cocotb did not
  yet support Python 3.14. nixpkgs' current default `python3` is already **3.14.7**.
  Bump `pythonEnv` back to the latest nixpkgs Python once a cocotb that supports it
  ships — re-check with `nix eval nixpkgs#python3Packages.cocotb.version` and drop
  the explicit pin.
- **RISC-V cross-GCC.** Left commented in `nix/packages.nix`; enable at Phase 7
  (`.insn` macros / toolchain work). May build from source the first time.
- **CVA6 packaging.** The source is pinned via Nix, but `make verilate` runs
  imperatively in the dev shell (see the base-core note above). Turning the whole
  sim into a pure Nix derivation is deferred — it is a real project (Spike DPI,
  writable-tree build). Revisit if CI reproducibility demands it.

## How to regenerate this snapshot

Enter the shell and print versions:

```sh
nix develop --command bash -c '
  verilator --version; svlint --version; yosys --version
  spike --help 2>&1 | head -1; qemu-system-riscv64 --version | head -1
  python3 --version; python3 -c "import cocotb, scapy; print(cocotb.__version__, scapy.__version__)"
  pdftotext -v 2>&1 | head -1; gcc --version | head -1; make --version | head -1
'
```
