randomizedcoder/rtl-fun/tb/parser_smoke_tb.sv

// parser_smoke_tb.sv — Verilator smoke / directed-suite test for the parser unit.
//
// Runs the generated slice program (verif/gen/gen_parser_rom.c) on a packet through
// parser_top and asserts the resulting metadata bytes equal the golden model's
// flow_keys, byte-for-byte, and that the exit code matches. Build/run:
// scripts/parser-sim.sh (nix run .#parser-sim, or .#parser-sim-suite for the
// whole directed suite). Requires Verilator `--assert` for the checks below.
//
// The per-packet parameters (PKT_LEN, META_LEN, EXP_CODE) are read at RUNTIME
// from params.hex, not compiled in — so a SINGLE build runs every suite case,
// each in its own directory with its own packet/expected/params.hex.

module parser_smoke_tb
  import parser_pkg::*;
;

  // shared check primitive + tally (tb_checks / tb_fails), so one run reports
  // every mismatch — same primitive parser_wrap_tb uses.
`include "tb_check.svh"

  // per-packet params, read at runtime from params.hex:
  //   [0] = PKT_LEN, [1] = META_LEN, [2] = EXP_CODE (32-bit two's complement)
  logic [31:0] params [0:2];
  int                 PKT_LEN;
  int                 META_LEN;
  logic signed [31:0] EXP_CODE;

  logic clk;
  logic rst_n;
  initial clk = 1'b0;
  always #5 clk = ~clk;

  logic [15:0]          parse_len;
  logic [META_OFF_W-1:0] meta_raddr;
  logic [7:0]           meta_rdata;
  logic                 done;
  logic signed [31:0]   code;
  logic                 busy;

  // Decode mode (nix run .#parser-sim-decode): source micro-ops from the 32-bit
  // Phase-3 words via parser_decode instead of the model-generated ROM, proving
  // the decoder produces byte-identical flow_keys + exit codes over the suite.
`ifdef PARSER_DECODE
  localparam bit USE_DECODE = 1'b1;
`else
  localparam bit USE_DECODE = 1'b0;
`endif

  parser_top #(
      .PROG_FILE("program.hex"),
      .CAM_FILE ("cam.hex"),
      .PKT_FILE ("pktbuf.hex"),   // buffer-sized image (packet.hex may exceed PKT_MAX)
      .ENC_FILE ("enc.hex"),
      .USE_DECODE(USE_DECODE)
  ) dut (
      .clk_i(clk), .rst_ni(rst_n),
      .parse_len_i(parse_len),
      .meta_raddr_i(meta_raddr), .meta_rdata_o(meta_rdata),
      .done_o(done), .code_o(code), .busy_o(busy),
      // ROM-only sim: packet from PKT_FILE, injection write port tied off.
      .pkt_wr_en_i(1'b0), .pkt_wr_addr_i('0), .pkt_wr_be_i(8'h0), .pkt_wr_data_i(64'h0)
  );

  // expected metadata bytes (the model's flow_keys image)
  logic [7:0] exp_mem [0:META_MAX-1];

  // waveform dump — enabled only in the trace/debug Verilator targets
  // (nix run .#parser-sim-trace / .#parser-sim-debug), which pass +define+DUMP.
`ifdef DUMP
  initial begin
    $dumpfile("parser.vcd");
    $dumpvars(0, parser_smoke_tb);
  end
`endif

  initial begin
    // per-packet params (runtime): PKT_LEN, META_LEN, EXP_CODE
    $readmemh("params.hex", params);
    PKT_LEN  = int'(params[0]);
    META_LEN = int'(params[1]);
    EXP_CODE = $signed(params[2]);

    for (int i = 0; i < META_MAX; i++) exp_mem[i] = 8'h0;
    $readmemh("expected.hex", exp_mem);
    parse_len  = PKT_LEN[15:0];
    meta_raddr = '0;

    // reset
    rst_n = 1'b0;
    repeat (4) @(posedge clk);
    rst_n = 1'b1;

    // run until the parser exits (guarded)
    fork
      begin : run
        int cyc;
        cyc = 0;
        while (!done && cyc < 5000) begin @(posedge clk); cyc++; end
        check(done, "parser reached done");
      end
    join

    // exit code matches the model
    check(code == EXP_CODE, "exit code == model exit code");

    // metadata (flow_keys) matches the model, byte for byte
    for (int b = 0; b < META_LEN; b++) begin
      meta_raddr = b[META_OFF_W-1:0];
      #1;   // settle combinational read
      check(meta_rdata == exp_mem[b],
            $sformatf("meta[%0d]=%02x exp=%02x", b, meta_rdata, exp_mem[b]));
    end

    $display("--------------------------------------------------");
    $display("parser smoke: exit code = %0d (expected %0d)", code, EXP_CODE);
    $display("parser smoke: %0d checks, %0d failures", tb_checks, tb_fails);
    if (tb_fails == 0) $display("parser smoke: PASS");
    else               $display("parser smoke: FAIL");
    $display("--------------------------------------------------");
    if (tb_fails != 0) $fatal(1, "smoke test failed");
    $finish;
  end

endmodule : parser_smoke_tb
