randomizedcoder/rtl-fun/rtl/parser_cam.sv

// parser_cam.sv — behavioral CAM lookup (Phase 5, §4.3/§4.6).
//
// A CAM entry is a 20-bit key (share[3:0] + match[15:0]) → 32-bit target, per the
// patent (20-bit key + 32-bit target). This is the *behavioral* model chosen for
// bring-up (phase-5 §5.6 decision); a synthesizable structure lands later behind
// this same interface. Entries are loaded by the testbench via a hierarchical
// $readmemh into `entry`; in the real core they are written from the integer side
// via the custom-3 CPPRSWRCAM path (see docs/analysis/cva6-integration.md).
//
// Lookup mirrors cam_lookup() in parser.c: match on (share == req_share) &&
// (match == req_match); first hit wins; miss → hit_o = 0.
//
// PROGRAM PORT (I4b): in the real core, entries are written from the integer side
// via the custom-3 CPPRSWRCAM path (prog_en_i pulses on the executing op). A write
// (prog_valid_i=1) stores {1,share,match,target} at prog_index_i; a delete
// (prog_valid_i=0, the CPPRSWRCAM D bit) clears that entry. The clocked write and
// the combinational lookup share the `entry` array (write-before-read within a
// cycle is not relied upon: a dependent lookup issues in a later cycle). NOTE:
// CAM programming is not yet speculation-safe (no commit-gate / flush rollback) —
// a deliberate deferred escalation, see docs/analysis/cva6-implementation-status.md.

module parser_cam
  import parser_pkg::*;
#(
    parameter string INIT_FILE = ""            // sim: CAM entries ($readmemh)
) (
    input  logic        clk_i,
    // ---- program port (custom-3 CPPRSWRCAM) ----
    input  logic        prog_en_i,             // write/delete this cycle
    input  logic [CAM_IDX_W-1:0] prog_index_i, // entry index (= regs[Rs])
    input  logic        prog_valid_i,          // 1 = write entry, 0 = delete (clear)
    input  logic [3:0]  prog_share_i,
    input  logic [15:0] prog_match_i,
    input  logic [31:0] prog_target_i,
    // ---- lookup port ----
    input  logic [3:0]  share_i,
    input  logic [15:0] match_i,
    output logic        hit_o,
    output logic [31:0] target_o
);

  // one packed word per entry: {valid, share[3:0], match[15:0], target[31:0]}
  localparam int unsigned ENTRY_W = 1 + 4 + 16 + 32;   // 53
  logic [ENTRY_W-1:0] entry [0:CAM_DEPTH-1];
  initial begin
    // Zero-init for simulation only; under yosys (+define+SYNTHESIS) a zeroing loop
    // before $readmemh clobbers the file init (docs/phase-8-status.md #18).
`ifndef SYNTHESIS
    for (int i = 0; i < CAM_DEPTH; i++) entry[i] = '0;
`endif
    if (INIT_FILE != "") $readmemh(INIT_FILE, entry);
  end

  // clocked program write/delete (CPPRSWRCAM). Index is bounds-safe by width.
  always_ff @(posedge clk_i) begin
    if (prog_en_i)
      entry[prog_index_i] <= prog_valid_i
          ? {1'b1, prog_share_i, prog_match_i, prog_target_i}
          : '0;   // delete: clear valid + payload
  end

  always_comb begin
    hit_o    = 1'b0;
    target_o = 32'h0;
    for (int i = 0; i < CAM_DEPTH; i++) begin
      logic        v;
      logic [3:0]  sh;
      logic [15:0] mt;
      logic [31:0] tg;
      {v, sh, mt, tg} = entry[i];
      if (!hit_o && v && (sh == share_i) && (mt == match_i)) begin
        hit_o    = 1'b1;
        target_o = tg;
      end
    end
  end

endmodule : parser_cam
