randomizedcoder/rtl-fun/(commit log)

2026-08-13 docs: add local reference library
    Blog transcription (live page 403s), US patent 12,461,885 (PDF+text),
    RISC-V ISA manual (PDF+text), Linux flow_dissector.c, plus a provenance
    README and a re-download/extract script.
2026-08-13 docs: add patent-conformance analysis vs US 12,461,885
    Compares the design-doc set against the full patent (not just the blog):
    32-register file, ~40+ instructions, two-level parsing with databound,
    Loop-vs-Next end-of-node, encapsulation/metadata-frames, counters, and the
    custom-0 0x0b encoding. Flags gaps and gives a prioritized correction list
    for Phase 1/3/4. Links it into the docs index.
2026-08-13 docs: align phase docs with the full patent ISA (P0+P1+P2)
    Phase 1: full 32-register file, two-level parsing + DataBound, real
    end-of-node (Loop-then-Next, overlay, encapsulation), full instruction
    families, load attributes, compare variants, counters, parser codes.
    Phase 2: two-level pstate (CurHdr/DataHdr/DataBound) + parser codes.
    Phase 3: re-based on custom-0 0x0b + 4-bit function + custom-3 moves,
    bit-31 address/code encoding, control bits, Sz tables, CAM key union.
    Phase 4/5: databound/loop/counters/frames state, two-stage EON, CAM key
    union. Overview risk R2 + ISA-scope; glossary terms.
2026-08-13 docs: recover custom-3 coprocessor encodings — 100% coverage
    FIG 43/44 give the custom-3 coprocessor instruction formats (CPPRSRD/WR/
    WRIMM/RDCAM/WRCAM/RDARRAY/WRARRAY) on opcode 0x7b, and FIG 42 the full
    p0-p31 register-initialization table. Added ASCII diagrams + discriminator/
    assembly tables to the encodings note, the register map, and closed the last
    gap. bitgen.py extended; Phase 3 and conformance analysis now state full
    encoding coverage.
2026-08-13 docs: add ADR-002 — parser-unit HDL choice (SystemVerilog)
    Records the HDL/language decision in Phase 0 with a full options table
    (SystemVerilog, SpinalHDL, Bluespec, Chisel, Amaranth, Veryl), pros/cons,
    and rationale: the patent's tightly-coupled ISA favors staying in CVA6's
    SystemVerilog (no language boundary at the decode/issue/EX integration),
    with decode/encode tables generated from the ISA table. SpinalHDL noted as
    the flip-condition alternative. Linked from the overview ADR section.
2026-08-13 chore: add Nix flake + modular nix/ dev shell
    Reproducible dev environment via 'nix develop', modeled on xdp2's modular
    nix/ layout. flake.nix wires nix/packages.nix (tool groups: docs/rtl/sim/
    toolchain/common) and nix/devshell.nix (mkShell + rtl-help banner).
    Tools: poppler-utils, python3.13 + cocotb/pytest/scapy, verilator, verible,
    svlint, gtkwave, yosys, spike, qemu, plus common utils. RISC-V cross-gcc left
    as a commented extension point for Phase 7. Python pinned to 3.13 (cocotb
    2.0.1 does not support 3.14 yet).
    Adds docs/nix.md (layout + how to extend), references it from the README and
    docs index, and .gitignore for nix result symlinks. Verified: nix develop
    builds and all tools re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
2026-08-15 feat(phase-0): CVA6 Verilator baseline + RISC-V cross-toolchain (Nix) (#7)
    Prove the toolchain integration end-to-end by building the stock CVA6
    Verilator model (Variane_testharness, target cv64a6_imafdc_sv39) entirely
    from Nix-provided components — the base core for the parser-instructions
    RTL work.
    - nix/cva6.nix: pin CVA6 v5.3.0 via fetchFromGitHub (fetchSubmodules).
    - nix/packages.nix: add bare-metal riscv64-none-elf toolchain
    (pkgsCross.riscv64-embedded gcc + binutils), copying the working
    x86->riscv cross-compile pattern from the xdp2 flake.
    - scripts/cva6-baseline.sh + nix/cva6-baseline.nix: baseline build,
    packaged as a writeShellApplication (tools on PATH, shellcheck-clean)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
2026-08-15 docs: sync phase-status surfaces with reality (Phase 0 & 1 done) (#9)
    The two status surfaces had drifted behind merged work:
    - docs/README.md phase table showed Phase 0 as "In progress" though its CVA6
    Verilator baseline + RISC-V toolchain + environment snapshot are built/merged;
    Phase 1 as "Ready" though its normative semantics are complete/merged.
    - root README "## Status" still said "design phase, no RTL, docs only".
    Fixes:
    - Phase 0 → Done, Phase 1 → Done in the docs index.
    - Clarify the legend to track phase *execution* (not just the doc) and add a
    Progress/Next note.
    - Rewrite root README Status as a per-phase ✅/next list; keep the honest caveat
    that source dirs are sti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
2026-08-15 feat(model): Phase 2 golden reference model + pinned corpus + pm-trace (#10)
    Add the Phase-2 golden reference model (model/libparsermodel): a
    decoded-instruction interpreter (pm_run walks a decoded-instr table) with one
    execute_* per opcode mirroring the normative Phase-1 semantics 1:1. The slice
    program parses Ethernet -> IPv4/IPv6 -> TCP/UDP into a flow_keys.
    - Packet corpus is the xdp2 proto_audit pcap_templates (378 pcaps), pinned by
    commit + narHash (nix/xdp2.nix) and injected as CORPUS_DIR, so vectors are
    reproducible. Smoke slice targets eth + ip + udp/tcp.
    - Dependency-free assert harness (model/test) for unit + corpus smoke tests.
    - Nix apps: `nix run .#model-test` and `nix run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
2026-08-15 feat(model): Phase 2 coverage — VLAN, IPv6 ext headers, hostile corpus (#11)
    Extend the golden model past the smoke slice to complete Phase 2's §2.3 matrix.
    No new opcodes were needed — only new nodes and CAM tables:
    - VLAN (802.1Q/802.1ad): a vlan_node reachable from the EtherType table that
    self-loops for stacked tags (QinQ). node-count guard bounds the nesting.
    - IPv6 extension headers: a dedicated IPv6 next-header CAM table (share=3, so it
    never pollutes IPv4's next-protocol table) routes hop-by-hop/routing/dest-opts
    through a generic ext node (len=(ExtLen+1)*8), fragment through a fixed-8 node,
    and "no next header" (59) to a clean STOP_OKAY. ip_proto tracks the chain.
    - ip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
2026-08-16 feat(isa): Phase 3 — bit-accurate instruction encoding (#12)
    Give every parser instruction its exact encoding from the patent (US 12,461,885,
    FIG 43-47), per the pixel-verified bit ranges in patent-encodings-recovered.md.
    Decision honored: 32-bit custom-0 forms + custom-3 coprocessor R-form first;
    64-bit form deferred.
    - isa/parser-opcodes.yaml — the machine-readable source of truth: framing
    (custom-0 0x0b + Fnc4; custom-3 0x7b), the Fnc4 group map, Sz rules, per-group
    field bit-ranges + discriminators, next-word/CAM-key formats, and Parser Codes.
    - model/libparsermodel/encoding.{h,c} — C encoder/decoder mirroring the YAML;
    per-group prs_enc_* + pm_encode() for the model's opcod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
2026-08-16 docs: Phase 4 — parser microarchitecture decided at signal granularity (#13)
    Turn the Phase-4 draft into decisions (D1–D7), grounded in the pinned CVA6
    v5.3.0 source, and add a signal-level CVA6 integration map that Phase 5 wires
    against.
    Decisions:
    - D1 packet data: dedicated 256 B on-chip buffer, 128-bit read window (Option
    B-lite); A-vs-L1D measured in Phase 9. PKT_WINDOW_W parameterized.
    - D2 attachment: custom-0 = new in-pipeline fu_t::PARSER (needs fetch redirect);
    custom-3 = CV-X-IF. RoCC/acc_dispatcher rejected (ADR-002).
    - D3 latency: variable-latency FU (ready/valid), outside CVA6's one_cycle FLU
    path; 1 cyc load/len/cmp, 2–3 cyc cam+end-of-node.
    - D4 redirect: reuse b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
2026-08-16 feat(rtl): Phase 5 — parser unit in SystemVerilog, runs the slice in Verilator (#14)
    The parser datapath is implemented as synthesizable SystemVerilog and runs the
    vertical slice in Verilator, producing a flow_keys that matches the golden C
    model BYTE-FOR-BYTE (nix run .#parser-sim -> 50 checks, 0 failures, STOP_OKAY).
    The RTL is a hardware pm_run: it interprets the SAME decoded program the model
    runs. gen/gen_parser_rom.c emits the program/CAM/packet/expected vectors from
    pm_slice_program() — one source of truth, no hand-kept second copy.
    Modules (rtl/):
    - parser_pkg types, params, ROM word layout, extract_subreg/bswap_n
    - parser_pktbuf packet buffer + 128-bit window + byte ali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
    [cva6_parser_wrap.sv, parser_cam.sv, parser_execute.sv, parser_pkg.sv, parser_pktbuf.sv, parser_smoke_tb.sv, parser_top.sv]
2026-08-16 test(verify): Phase 6 verification foundation — assertions, formal, suite, static analysis, fuzzing (#15)
    Adds a verification foundation across all four techniques, every target
    green from the flake:
    - Toggleable design assertions (rtl/parser_asserts.svh): PRS_ASSERT /
    PRS_ASSERT_I expand to real SVA only under +define+PARSER_ASSERT (sim)
    or +FORMAL (proof), else nothing — same RTL stays synthesizable. Safety
    assertions in parser_top + handshake assertions in cva6_parser_wrap.
    On for every sim (nix run .#parser-sim).
    - Formal proof (nix run .#parser-formal): sv2v flattens the SV, SymbiYosys
    (z3) proves parser_execute never writes metadata out of bounds, only
    writes 1/2/4/8 b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
2026-08-16 feat(rtl): parser_decode.sv — 32-bit Phase-3 word -> micro_op_t, proven vs model (#16)
    Adds the CVA6 decode path as a pure combinational unit and proves it end-to-end.
    - rtl/parser_decode.sv: turns a 32-bit custom-0 word into a micro_op_t, mirroring
    model/libparsermodel/encoding.c (pm_decode_opcode + per-group field extraction)
    and isa/parser-opcodes.yaml bit-for-bit (LSB0, Fnc4 group map, per-group slots).
    CAM/next targets are not in the word (they live in the CAM table, resolved at
    run time), so the decoder emits every field the executor needs and the target
    arrives on cam_target_i.
    - Decode co-sim (nix run .#parser-sim-decode): the generator emits enc.hex (the
    32-bit words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
    [parser_decode.sv, parser_smoke_tb.sv, parser_top.sv]
2026-08-16 feat(cva6): in-core decode patch — route custom-0/3 to a PARSER FU, layered as cacheable derivations (#17)
    Starts the in-core CVA6 integration (Phase 5 §5.2/§5.5) with the decode stage,
    structured as small cacheable Nix derivations with unpatched-vs-patched targets.
    - nix/cva6-parser/decode.patch: adds PARSER to fu_t and PARSER_C0/PARSER_C3 to
    fu_op (ariane_pkg.sv), and routes riscv::OpcodeCustom0/Custom3 to fu=PARSER in
    decoder.sv. The parser micro-op is decoded inside the FU (rtl/parser_decode.sv),
    so the core decoder only routes + marks integer operands. Plain unified diff so
    it reviews on its own.
    - nix/cva6-patched.nix (cva6-parser-src): applies the patch to the pinned sour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
2026-08-16 feat(cva6): in-core issue/EX/writeback/redirect — parser ops execute in-core (#18)
    Turns the CVA6 patch from "decoded" to "executed". Custom-0/custom-3 now flow
    through the full pipeline: ISSUE ready/valid handshake -> EX-stage FU
    (cva6_parser_wrap + parser_decode/pktbuf/cam) -> a new writeback port -> retire,
    with an end-of-node redirect muxed onto resolved_branch_o.
    Lands as nix/cva6-parser/issue-ex.patch (layered on decode.patch by the cached
    cva6-parser-src derivation):
    - issue_read_operands.sv / issue_stage.sv: parser_valid/parser_ready strobes,
    single-in-flight busy interlock, raw instruction word carried like CVXIF's
    x_off_instr.
    - ex_stage.sv: instantiate the parser FU; branch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
2026-08-16 docs: evaluate the in-core CVA6 parser test — gaps + verification roadmap (#19)
    cva6-parser-test is the correctness gate that keeps parser-instruction bugs off
    silicon, so this adds a tapeout-oriented risk register for the IN-CORE surface.
    - What the test proves today: a liveness/smoke check (decode routing, issue
    handshake, retire, no trap/hang, no spurious redirect, elaboration) — but it
    never checks a computed value, covers one op (load) of nine, and runs only on
    the quiescent non-speculative path.
    - Gap analysis ranked by tapeout risk, incl. two P0 correctness gaps: no in-core
    value/co-simulation (packet window + CAM empty-backed, metadata sink dangling),
    and a speculation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
2026-08-16 feat(cva6): I1 — commit-visible parser state (speculation-safety fix, G2) (#21)
    * feat(cva6): I1 — commit-visible parser state (speculation-safety, G2)
    The parser FU committed its persistent register state (pstate_t st_q) at
    EXECUTE time, gated only by a same-cycle ~flush_i. A parser op squashed by a
    LATER flush (an older instruction's exception/eret/fence/CSR side-effect —
    the only events that assert flush_ex to the FU; a branch mispredict flushes
    only un-issued instrs + IF, per controller.sv) had already mutated st_q,
    which was never rolled back — corrupting all subsequent parsing. This is the
    Spectre-class "speculation must leave no surviving state" bug (gap G2).
    Fix (Design B,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
    [cva6_parser_wrap.sv, parser_wrap_tb.sv]
2026-08-16 feat(cva6): I2 commit-gated metadata sink + first in-core value-check (#22)
    Closes gaps G1 (no in-core value checking) and G8 (metadata sink undefined)
    for the in-core parser FU, per docs/analysis/cva6-verification-design.md §1.
    RTL (cva6_parser_wrap.sv): add a 64x8 metadata frame (meta_mem, mirrors
    parser_top.sv). The per-op metadata write {we,off,wdata,nbytes} from
    parser_execute is buffered in the pending FIFO and byte-scattered into the
    frame ONLY on commit — the same speculation-safety gate as the register state
    (I1), mirroring the LSU store buffer. A squashed op never dirties the frame;
    a flush discards the queue. Replaces the _unused_meta dead-end.
    Verification:
    - parser_wrap_tb.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
    [cva6_parser_wrap.sv, parser_wrap_tb.sv]
2026-08-16 feat(cva6): I4a end-of-node fetch redirect (node-index -> byte PC, G3) (#24)
    Make a parser NEXTNODE jump steer the CVA6 frontend, closing gap G3 for the
    non-CAM redirect path (I4a; CAM-driven redirect + mux-exclusivity SVA deferred
    to I4b). cva6_parser_wrap now drives resolve_branch_o + a byte-translated
    redirect_pc_o = pc_i + (target_node - cur_node)*4, muxed into resolved_branch_o
    (is_mispredict) in ex_stage. Parser register state and the metadata frame stay
    commit-gated (I1); only the fetch steer is speculative, exactly like a branch.
    Two fixes were needed that only show up in-core (the isolated wrap-TB checks the
    delta math but not the frontend contract):
    1. Same-cycle (combinational)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
    [cva6_parser_wrap.sv, parser_wrap_tb.sv]
2026-08-16 feat(cva6): I4b CAM programming (custom-3) + CAM-hit redirect (G3 CAM path) (#25)
    Program the parser CAM from the integer side and use it in-core, unblocking
    OP_CAMNEXT (a programmed CAM entry now drives a real end-of-node redirect).
    - rtl/parser_cam.sv: clocked write/delete program port (combinational lookup kept)
    - rtl/parser_pkg.sv: micro_op_t wr_preg/wr_cam/rd_cam/cam_del + CAM_IDX_W
    - rtl/parser_decode.sv: decode custom-3 CPPRSWR / CPPRSWRCAM / CPPRSRDCAM
    - rtl/cva6_parser_wrap.sv: rs1_i operand; write_preg; CAM program drive
    (index=rs1, {key,target}=p[cpreg] per patent); CPPRSRDCAM lookup mux;
    CPPRSWR commit-gated via the I1 pending queue; updated SVA
    - nix/cva6-parser/issue-ex.pa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
    [cva6_parser_wrap.sv, parser_cam.sv, parser_decode.sv, parser_pkg.sv, parser_top.sv, parser_wrap_tb.sv]
2026-08-17 feat(cva6): I5 in-core packet→flow_keys cosim over real MMIO (G5/G9; closes I2 MMIO escalation) (#26)
    Delivers the first true packet→flow_keys equivalence check INSIDE the CVA6
    pipeline, and closes the deferred I2 sim-only-backdoor escalation by building the
    real thing: a SoC AXI MMIO peripheral so a bare-metal program `sd`s a packet in
    and `ld`s the committed flow_keys back out.
    What lands
    - Real MMIO peripheral (nix/cva6-parser/mmio.patch): axi2mem-bridged SoC slave at
    ariane_soc::ParserBase (0x5000_0000) — packet-buffer write, ParseLen, exit-landing
    PC, latched exit status, and flow_keys read; ports threaded ariane→cva6→ex_stage→FU.
    - rtl/parser_pktbuf.sv: clocked 64-bit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
2026-08-17 docs: reconcile verification docs + newcomer testing map (PR-1) (#27)
    Follow-on verification-refactor, part 1 of 5 — documentation/pointer fixes only,
    no test logic touched.
    Reconcile design ↔ tracker ↔ code (drift accumulated across I1–I5):
    - Mark I2/I3/I4a/I4b ✅ (all merged to main); resolve stale "this PR" → #25/#26.
    - G4: reflect that custom-3 write + CAM program/readback merged in I4b (#25),
    not just the I3 read; owner I3/I4b, state ✅.
    - G7: make a single consistent state across design §3 and the tracker
    (V9 parse-exit redirect done in I5; V6/V7/V10 deferred).
    - Add one canonical deferral list (design §3.1) as the single source of truth;
    point the tracker and the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
2026-08-17 refactor: give tests a home — move TBs to tb/, generator+formal to verif/ (PR-2) (#28)
    Follow-on verification-refactor, part 2 of 5 — mechanical file moves + path
    updates only, no behavioral change. rtl/ now holds synthesizable RTL only.
    Moves (git-detected renames):
    - rtl/parser_top.sv, parser_smoke_tb.sv, parser_wrap_tb.sv -> tb/
    - rtl/gen/gen_parser_rom.c -> verif/gen/
    - rtl/formal/{parser_execute_fp.sv,parser_execute.sby} -> verif/formal/
    Path updates (all references repointed):
    - scripts/parser-sim.sh (gen -> verif/gen; TB srcs -> tb/; new TB/VERIF vars)
    - scripts/parser-wrap-test.sh (tb/parser_wrap_tb.sv)
    - scripts/parser-analyze.sh (tb/pa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
2026-08-17 chore(verif): DRY the parser runners — shared bash lib, one TB primitive, unified naming (#29)
    Collapse the duplication that accumulated across the test runners as the FU was
    built increment by increment (PR-3 of the verification refactor).
    Shared bash lib (readFile-prepended by the Nix wrappers, same concatenation model
    as cva6-baseline.sh; dev-shell fallback sources it directly):
    - scripts/lib/common.sh — canonical paths (one REPO_ROOT-derived scheme),
    gen_vectors (model→vectors build+invoke), rv_assemble (bare-metal RV64GC link,
    RV_INCLUDES-aware), run_model + model_success (run + SUCCESS gate), and the
    shared PARSER_VFLAGS Verilator flag set.
    - scripts/lib/suite.sh — run_s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
2026-08-17 test: close Table A rows 16-22 (edge packets) — both suites 22/22 (#30)
    Add the seven deferred Table-A edge-packet cases as new builders in the
    shared generator (verif/gen/gen_parser_rom.c); because one generator feeds
    both the standalone RTL suite and the in-core cosim, the rows land in both
    at once. The generator self-checks every case against the golden model and
    fails the build on any OK/fail disagreement, so the expected verdicts below
    are the model's own:
    16 ipv4 ihl=15 (60-B header, max options) OK (-4) full header walk
    17 ipv4 ihl=0 (illegal) fail (-14) min-length trap
    18 deep VLAN stack (40 tags) fail (-24) MAX_NODES guard
    19 len=0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
    [parser_smoke_tb.sv]
2026-08-17 test: close Table-B negatives + V4/V5/V11 (G6/G13) (#31)
    Fifth PR of the verification-refactor sequence. Adds the directed rows the
    corpus doesn't cover incidentally, closing the achievable half of Table C
    plus the Table-B negative column.
    Wrap-TB (tb/parser_wrap_tb.sv) — three new assertion-based scenarios:
    - Sc.0 V11 reset/X: out of reset the speculative + architectural state and
    the handshake outputs are $isunknown-free, agree, and the first op
    yields a defined result (closes G13).
    - Sc.9 V4 WAW: two CPPRSWR writes to p16 both in flight, committed in order;
    the younger wins in the architectural shadow and on readback.
    - Sc.10 store-past-frame: a st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
    [parser_wrap_tb.sv]
2026-08-17 test: negative control — stock core must trap the parser word (G11, N1) (#32)
    Adds `nix run .#parser-negative-control`: build the STOCK (unpatched) CVA6
    model and run the *identical* custom-0 PARSER word the patched core executes.
    On the base RV64GC decoder it is an illegal instruction (mcause=2); the trap
    handler writes tohost=1 -> fesvr SUCCESS, so the pass IS the assertion — the
    parser ops are a genuine ISA extension, not something the stock core already
    accepts. This is the negative twin of cva6-parser-test and closes the
    negative-control half of G11 (the base-ISA regression half remains N6).
    - tests/cva6-parser/negctl.S — custom-0 word guarded by an mtvec trap handler.
    - scripts/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
2026-08-17 feat: CPPRSWRIMM immediate-load custom-3 form (N2, §3.1 item 6) (#33)
    Completes the custom-3 coprocessor ISA: the immediate-load move writes a
    parser register from an 11-bit split immediate (Imm2[20:15], Imm1[11:7]),
    with no integer source or destination. It rides the same I1 pending-queue
    commit-gate as CPPRSWR, so a squashed speculative immediate write leaves no
    architectural trace.
    RTL:
    - parser_pkg: add wr_preg_imm + imm[10:0] to micro_op_t; zero both in
    mop_from_word (the custom-0/ROM path never carries a custom-3 move).
    - parser_decode: split the custom-3 leg on the I bit. I=0 keeps the
    register/CAM {R,Func3} decode; I=1,Func3=1 decodes CPPRSWRIMM and extracts
    imm = {word[20:15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
2026-08-17 feat: commit-gate CPPRSWRCAM — CAM-write speculation safety (N3, §3.1 item 5) (#34)
    Closes the last speculation-safety hole. CPPRSWRCAM previously programmed the
    CAM at EXECUTE, so a squashed speculative CAM write left a stale entry. It now
    rides the same I1 pending-queue commit-gate as parser register state and the
    metadata frame.
    rtl/cva6_parser_wrap.sv:
    - pend_t gains {cam_we, cam_valid, cam_index, cam_share, cam_match, cam_target};
    a CPPRSWRCAM buffers these on accept and the CAM program port is driven from
    the COMMITTING head entry (cam_prog_en_o = commit_cam), so the CAM is written
    only on commit. op_wr_cam joins needs_queue; st_adv holds parse state
    unchanged for a CAM wri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
2026-08-17 test: V7 in-core faulting-instruction squash + reusable trap scaffold (N4, G7) (#35)
    A preceding faulting instruction that flushes an in-flight parser op must not
    corrupt its committed result — the I1 speculation-safety path (flush -> rollback
    -> re-execute), now demonstrated end-to-end in-core through a real machine-mode
    exception. FU-level rollback is already proven by parser_wrap_tb Sc.1/4/11; this
    closes Table C V7 (part of gap G7).
    - tests/cva6-parser/trap.S — reusable M-mode trap scaffold: a TRAP_SETUP macro
    (mtvec + mscratch-anchored save block) and a handler that is transparent to the
    interrupted code (saves/restores t0-t3), counts every trap in trap_count, and
    dispatches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
2026-08-17 test: V6 in-core interrupt-mid-parse squash + resume (N5, G7) (#36)
    Close V6 (Table C): an asynchronous machine interrupt that flushes an
    in-flight parser op mid-parse must not corrupt its committed result — the
    asynchronous companion to V7's synchronous ecall (N4). Together V6+V7 cover
    both flavours of the single-cycle flush_i the parser FU sees, closing G7 for
    the realized parser state (only V10 context-switch remains, decision-gated on
    the D7 ABI).
    Mechanism: reuse the trap.S scaffold. The handler gains an interrupt leg
    (mcause MSB set -> .Lint) that clears the CLINT msip source so the interrupt
    fires exactly once, then mret's WITHOUT advancing mepc — the squashed
    instruction re-exec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
2026-08-17 test: base-ISA regression (G11) + 2nd CVA6 config (G10) (N6) (#37)
    Close the two CI-confidence gaps that a config change to the shared pipeline
    demands: prove the parser patch is (a) transparent to the base ISA and (b) not
    tied to the one config it was developed against.
    G11 base-ISA regression — cva6-parser-baseisa:
    base_isa.S retires a directed representative slice of RV64GC on the PATCHED
    core: integer (RV64I incl. *w), M (mul/mulhu/div/rem/mulw/divw), A (amoadd.d,
    lr.d/sc.d), F/D (fadd/fmul/fdiv/fsqrt/fcvt/feq/flt, single + double, fsw/flw
    round-trip), Zicsr (csrrw/csrrs/csrrc), every branch flavour taken+not-taken,
    and JAL/JALR linkage — each result value-checked. Every F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
2026-08-17 test: parser coverage — line/toggle + 100% functional cover closure (N7, G12) (#38)
    Close G12: measure coverage and define "done". New app parser-coverage
    (nix run .#parser-coverage) builds the smoke suite + wrap-TB under Verilator
    --coverage-line --coverage-toggle --coverage-user (+define+PARSER_COVER), runs
    them, merges every coverage.dat with verilator_coverage, and gates on 100% of
    the functional cover points — the §2.6.5 V-table cross-product.
    Functional cover points (PRS_COVER macro in parser_asserts.svh, compiled out
    unless +define+PARSER_COVER, so normal sim/synth/CVA6 builds pay nothing):
    - op-CLASS bins in tb/parser_top.sv AND rtl/cva6_parser_wrap.sv — merged
    coverage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
2026-08-18 test: V10 in-core between-parse context switch — ratify D7 (§3.1 item 4, G7) (#39)
    Prove the parser's architectural register state survives a context switch by
    reusing the existing custom-3 move ABI, ratifying design decision D7.
    tests/cva6-parser/parser_ctxsw_v10.S spills thread A's parser context to memory
    via CPPRSRD (`prs.mv.x.p`), has a simulated thread B clobber every writable
    p-reg (asserting each actually changed — guards a "writes ignored" false pass),
    reloads A via CPPRSWR (`prs.mv.p.x`), and asserts every register came back
    bit-for-bit — in-core over the real commit-gated pipeline (no MMIO/trap/backdoor,
    like parser_trap_v6.S). tohost=1 PASS; 11=clobber ignored, 10=lossy r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
2026-08-18 test: M1 in-core mid-parse context switch — register-state save/restore/resume (§3.1 item 4, G7) (#40)
    Extend the custom-3 move ABI to the parser's in-progress position registers so a
    preempted parse can be saved, its writable regs clobbered by "another thread",
    restored, and resumed to the golden model's byte-exact flow_keys. Finishes the
    register half of the mid-parse context-switch deferral; only the M2 residual
    (meta_mem frame + CAM restore) stays deferred.
    RTL (rtl/cva6_parser_wrap.sv): read_preg/write_preg gain p1{cur_len,cur_off} and
    p2{dat_len,dat_off} (promoted read-only -> rw), p6 node_cnt, p7 encap, p8 next_pc
    (writable), plus p9 done (read-only). No ready-logic or SVA change.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
2026-08-18 test: formally prove cva6_parser_wrap G2 speculation/flush invariants (I1 formal follow-up) (#41)
    parser-formal now runs a second SymbiYosys proof on cva6_parser_wrap: an unbounded
    k-induction (verif/formal/parser_wrap.sby, mode prove) discharging the sequential G2
    speculation-safety SVAs — a_arch_committed (architectural state advances only on a
    commit) and a_flush_rollback (post-flush st_q == st_arch_q) — plus every other
    embedded wrap SVA, over ALL inputs. This closes the I1 formal follow-up: those
    properties were previously only directed-proven by parser-wrap-test.
    The invariants are 1-inductive (st_arch_q moves only under pend_commit; the flush
    block dominates the always_ff and dri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
2026-08-18 feat(verif): enable base-ISA RVFI-vs-Spike tandem lock-step (Phase 7, Stage 0) (#42)
    Stand up the dormant per-instruction RVFI-vs-Spike lock-step on the base ISA.
    The vendored core-v-verif already carries the tandem (spike.sv + DPI reference
    model + st_rvfi + rvfi_compare) behind `ifdef SPIKE_TANDEM, but nothing in the
    repo ever set it. This wires it on: every retired RV64GC instruction of
    base_isa.S is stepped against a source-built extended Spike and compared on
    insn/rd/pc/trap/mode + CSRs.
    nix run .#cva6-parser-tandem -> 287/287 instructions, 0 mismatches
    This is a strictly stronger G11 (base-ISA transparency) than N6's program
    self-check: every instruction is matched against an ind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
2026-08-18 feat: parser-op RVFI-vs-Spike lock-step (Phase 7 Stage 1a+1b) (#43)
    Teach the tandem Spike the parser ISA so parser ops get the same
    per-instruction lock-step oracle the base ISA already has (Stage 0).
    Stage 1a — pm_decode: the exact inverse of pm_encode (custom-0 word ->
    instr), plus a public pm_exec_one wrapper over the model's static
    exec_one. Proven by whole-slice round-trip (pm_encode->pm_decode->
    pm_encode word-identity) + field + illegal-word tests in model-test.
    Stage 1b — nix/spike-tandem/parser_ext.cc: a Spike customext extension
    that reuses libparsermodel (compiled straight into libcustomext.so) to
    own an independent pstate, decode+execute each retired custom-0/custom-3
    word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
2026-08-19 feat: packet-cosim RVFI-vs-Spike lock-step (Phase 7 Stage 1c) (#44)
    Close the last parser-op gap: teach the tandem Spike the 0x5000_0000 MMIO
    packet peripheral so the full packet->flow_keys corpus lock-steps, not just
    the packet-independent ops (Stage 1b).
    libriscv (nix/spike-tandem/{parser_shared,parser_mmio}.h, injected via
    spike-tandem.nix): a smart abstract_device_t at 0x5000_0000 that shares a
    parser_shared mailbox with the customext extension via an extern "C" global
    (the correct libcustomext -> libriscv link direction). The CPU's own `sd`
    stores land the packet / ParseLen / exit-PC on both sides, so PLOAD/PLENCUR
    read identical bytes; the device serves computed STATUS (0x100) / META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
    [parser_ext.cc, parser_mmio.h, parser_shared.h]
2026-08-19 feat: constrained-random + real-corpus packet campaign under RVFI-vs-Spike lock-step (Phase 7 Stage 2) (#45)
    Realize the tandem arc's Stage 2 as a constrained-random + real-pcap-corpus
    PACKET campaign fed through the existing Stage-1c tandem harness. riscv-dv
    *proper* (random RV64GC instruction interleaving via corev-dv) stays deferred:
    its custom-op generator is SystemVerilog UVM whose only wired simulators are
    commercial (VCS/Xcelium/Questa/dsim) and the flake is Verilator-only. The
    parser's meaningful random axis is the packet (the parse program is one fixed
    pm_slice_program; the 22-case suite already varies packets only), so this
    extends Stage 1c from 22 curated packets to hundreds of ra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
2026-08-19 docs: reconcile phase status with merged reality (Phases 0–9 audit) (#46)
    The phase-status labels had drifted: docs/README.md marked Phase 5 & 6 as
    "In progress" and Phase 7 as "Draft", even though the in-core verification effort
    (I1–I5, the N-series, and the RVFI-vs-Spike tandem lock-step Stages 0–2, PRs
    #21–#45) had closed gaps G1–G13, met every Phase-5 exit criterion, and delivered a
    Spike custom extension — while the table still called that work unstarted. The
    prose and the status table contradicted each other (the Phase-6 paragraph already
    described the "287/287" tandem the table called Draft).
    Reconcile the docs to match what is merged to `main`, documentation only — no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
2026-08-19 feat: Phase 7 codegen spine — generate toolchain artifacts from the ISA yaml (§7.6) (#47)
    The docs promise "everything that touches bits is generated from or checked against
    isa/parser-opcodes.*", but no generator existed — the yaml was hand-maintained and
    only round-trip-tested against encoding.c. Build the real spine, Stage 0 of the
    Phase-7 toolchain work.
    - tools/parser-gen/parser_gen.py reads isa/parser-opcodes.yaml (a new mnemonics:
    block naming the assemblable custom-0 + custom-3 instructions, plus the existing
    groups: bit-truth) and emits toolchain/generated/:
    * parser-opc.inc — binutils opcode fragment (MATCH_/MASK_ macros + a
    PARSER_OPS(X) table with operand d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
2026-08-20 feat: Phase 7 L2 — binutils prs.* mnemonics + objdump (Hybrid syntax) (#48)
    Teach GNU as/objdump the parser instructions so assembly reads like real code
    instead of `.insn 4, <word>` blobs, and disassembly is human-readable — the
    Phase-7 Level-2 rung.
    Operand syntax is Hybrid: real register operands where they exist (the custom-3
    move ABI — GPR + parser p-register names like `prs.mv.p.x pnext, a0`) plus a
    dotted size suffix folding Sz (`prs.load.h 1, 12`), with positional immediates
    for the remaining custom-0 bitfields. The full prose syntax (`pcurptr+12`,
    `paccum[0]`, `value:mask`, `.stp`/`.fail`) is deferred to Stage 1.5 — it needs
    yaml/generator metadata that doesn't exist yet an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
    [parser-opcodes.yaml]
2026-08-20 feat: Phase 7 Stage 1.5 — additive prose operand sugar for prs.* (#49)
    Add the lossless, additive subset of the docs' prose operand syntax on
    top of the Stage-1 Hybrid syntax, so the parser mnemonics read like the
    blog without pinning any un-frozen ISA-notation decisions. Three sugar
    forms, each mapping cleanly and reversibly to encoder bits:
    prs.load.h 1, pcurptr+12 ; Offset via pcurptr+N (bare == 0)
    prs.store.b paccum[0], 8 ; Pos via paccum[i] sub-register index
    prs.cmpib 1, paccum[0], 0x40:0xF0 ; cmp Value:Mask as one value:mask
    Mechanism: tools/parser-gen emits a prose opcode row immediately before
    each Hybrid row for the same mnemonic (identical match/mask,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
2026-08-20 feat: Phase 7 Stage 2 — user-facing standalone parser Spike (#50)
    Add a runnable, standalone `spike` that understands the parser ISA, so a bare
    parser ELF can be executed directly on an independent reference simulator (the
    Spike leg of the Phase-7 exit criterion). Stages 0/1/1.5 gave the ISA a codegen
    spine + a binutils assembler/disassembler; this rung is the ISA simulator the
    user can actually run.
    nix run .#parser-spike # parser_tandem.S smoke + 22-case corpus == golden model
    Until now the only Spike built was `spike-tandem` (libraries-only, loaded via DPI
    by the CVA6 Verilator lock-step) — not runnable on its own. This adds:
    - nix/spike-parser.nix — source-builds a RUNNABLE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
2026-08-20 feat: Phase 7 Stage 3 — the slice parser written in C intrinsics on Spike (#51)
    Author the Phase-0 vertical-slice parser as ordinary C using the generated
    intrinsics, compile it bare-metal, and run it on the standalone parser Spike over
    the 22-case corpus == the golden model. This closes the SPIKE leg of the Phase-7
    exit criterion ("the slice, written in C with intrinsics, runs on Spike and QEMU
    matching the model"); the QEMU leg remains.
    nix run .#parser-spike-slice # -O2 compile -> byte-parity vs model ROM -> 22/0
    Until now the runnable Spike (Stage 2, #50) was still driven by a machine-generated
    .word stream (prog.S from pm_slice_program via the encoder) — nothing authored in C.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
2026-08-22 feat(phase7): teach QEMU the parser custom-0/custom-3 ops + packet MMIO (QEMU leg, PR A) (#52)
    Phase 7's exit criterion needs the self-checking parser ELFs to run on a
    patched qemu-system-riscv64 == the golden model, matching the Spike leg. This
    first PR teaches QEMU the two custom opcodes and the packet device; the 22-case
    corpus + C-slice runners land in PR B.
    `qemu-parser` = nixpkgs qemu 11.0.3, restricted to riscv64-softmmu (override
    hostCpuTargets) then overrideAttrs/postPatch to reuse model/libparsermodel
    unchanged (built as its own -w static_library so QEMU's stricter -Werror set
    can't fail on the model's plain C11):
    * custom-0 (0x0b) parse ops -> HELPER(parser_c0): pm_decode (fai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
    [parser_mmio.h, parser_shared.h]
2026-08-22 feat(phase7): parser-qemu[-slice] runners — the 22-case corpus + C slice == model on QEMU (QEMU leg, PR B) (#53)
    Closes the Phase 7 exit criterion: the slice parser, authored in C with the
    generated intrinsics, now assembles and runs on Spike AND QEMU == the golden
    model. PR A taught qemu-system-riscv64 the custom-0/custom-3 ops + the packet
    device; this PR adds the user-facing runners that exercise the full corpus.
    scripts/parser-qemu.sh is the QEMU twin of scripts/parser-spike.sh: same shared
    libs (common.sh vector-gen + rv_assemble, suite.sh, cosim.sh emitters), same
    self-checking ELFs, same SLICE=1 byte-parity guard — only the sim command +
    oracle differ (qemu-system-riscv64 -M spik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
2026-08-23 docs(phase7): freeze the parser assembly notation (prose-freeze PR 0) (#54)
    The Phase-7 prose-freeze needs its ISA-notation decisions pinned in the specs
    before any generator/binutils code. This PR is docs (+ yaml comments) only: it
    records the frozen notation and corrects the docs where they disagreed with the
    golden model. No encodings change.
    New normative "Assembly notation (frozen)" table (phase-1-isa-spec.md §1.12)
    covering all seven deferred items:
    * dotted suffixes that fold a bit into the mnemonic: .be (load E), .stp (group
    S / end-of-node), .min (length D), the cmp Er (.stop/.stopnode/.stopsub/.fail)
    and CAM Miss (.wild/.alt/...) qualifiers;
    * mnemonic aliases: prs.le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
    [parser-opcodes.yaml]
2026-08-23 docs(phase8): add Tang Mega 138K Pro FPGA bring-up plan (#55)
    Commit the Sipeed Tang Mega 138K Pro (Gowin GW5AST-138) bring-up plan as a
    Phase-8 candidate-platform reference: NixOS toolchain (open-source yosys /
    nextpnr-gowin / apicula where possible, Gowin EDA for hard IP), go/no-go
    feasibility questions (does CVA6 synthesize/fit/route on Gowin), and a staged
    experiment ladder (smoke -> LED -> CVA6 baseline -> BRAM packet window -> one
    custom instruction end-to-end -> counters -> baseline-vs-custom benchmark ->
    DDR3 -> 10GbE). Useful groundwork for Phase 8 once Phase 7 wraps.
    Link it from phase-8-fpga.md §8.1 (board selection) so it is discoverable.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
2026-08-23 feat(parser-gen): dotted-suffix bit-folding (.be/.stp + cmp Er suffixes) (#56)
    Phase-7 prose-freeze, PR 1 of 3. Fold discriminator/attribute FIELDS into
    dotted mnemonic suffixes (like size_class folds Sz), presentation-only —
    every spelling encodes to identical bits and round-trips through objdump.
    - load E -> .be (E=1 big-endian; bare = E=0)
    - cam/length S -> .stp
    - cmp Er -> .stop/.stopnode/.stopsub/.fail
    The folded field stays in `operands`, so the generated intrinsics keep it as
    a parameter and every word is unchanged; only emit_gas skips the field and
    cross-products it with the Sz suffix (56 -> 100 gas rows). Removed the now-
    redundant S:0 fixed pin on prs.lencur (S is the .s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
    [parser-opcodes.yaml]
2026-08-23 feat(parser-gen): single prs.cam via destination decoration (paccum/pnext -> D) (#57)
    Phase-7 prose-freeze, PR 2. Fold the CAM D bit into a leading destination
    pseudo-register (§1.12): paccum => D=0 (Accum), pnext => D=1 (Next). One
    prs.cam mnemonic, no prs.camnext — matching the patent's disassembly.
    Presentation-only: every encoding is byte-identical.
    - New yaml `dest: { field, map }` construct: prepends the field to `operands`
    (so the C intrinsic takes it as its first parameter) and renders it as the
    new `Xpc` gas operand (keyword->D[30] table, printed by objdump).
    - parser_gen.py: Insn.dest; _c0_args emits `Xpc` for the dest field; _args_bits
    knows Xpc -> D[30]. prs.cam + prs.c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
2026-08-23 feat(parser-gen): pmeta+N store displacement prose form (Xpe) (#58)
    Phase-7 prose-freeze, PR 3. store/storeimm Offset gains the `pmeta+N` prose
    form — a metadata-frame displacement (ps->meta), a base distinct from load's
    packet `pcurptr+N` since a store targets the metadata, not the packet (§1.12).
    - yaml: store/storeimm prose { Offset: metaptr }.
    - parser_gen.py: new `metaptr` prose kind -> the `Xpe` gas operand; _args_bits
    learns Xpe (N-bit displacement at S, like Xpo/Xpa).
    - binutils patch: new `Xpe` operand class in all three switches (validate joins
    the o/a group; parse the `pmeta` keyword like `pcurptr`; disasm prints
    `pmeta`); regenerated rows (storeimm gains prose rows, 84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
2026-08-23 feat(parser-gen): length-family notation (lenset aliases + pcurhdr + mult:min) (#59)
    Phase-7 prose-freeze, length family. Lands the coupled pieces together so
    objdump reaches the frozen canonical `prs.lensetmin.n pcurhdr, paccum[1], 4:20`
    in one step (§1.12). Presentation-only: bits unchanged (byte-parity holds).
    - Aliases: prs.lenset (D=0) / prs.lensetmin (D=1) fold D into the mnemonic name,
    replacing prs.lencur. Shift=7 (constant length) is the separate prs.lensetconst
    (Pos=0/Shift=7 pinned), emitted BEFORE prs.lenset so a Shift=7 word disassembles
    to the const spelling (else objdump would print mult=2^7=128, which mult:min
    rejects on reassembly).
    - Cosmetic-fixed dest: new `dest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
    [parser-opcodes.yaml, parser_slice.c]
2026-08-23 feat(parser-gen): cosmetic paccum dest on prs.load (Xpp) (#60)
    Close the last presentation-only item of the prose-freeze arc: every op now
    names its destination pseudo-register as the leading operand (§1.12). prs.load
    gains a required, cosmetic-fixed `paccum` that consumes no encoding bits — a
    load always targets the accumulator. Mirrors the length family's pcurhdr/Xph.
    Presentation-only: no encoding, model, or intrinsic-signature change. The
    generated parser-opc.{json,inc} and parser_intrinsics.h are byte-stable; only
    parser-opc-gas.inc changes (the 16 load rows gain a leading `Xpp,`, match/mask
    identical). prs_load's C signature is unchanged, so parser_slice.c and
    parser_gen_check.c ar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
    [parser-opcodes.yaml]
2026-08-23 feat(parser-gen): LLVM MC leg L1 — immediate-only parser ops via llvm-mc (#61)
    Begin the Phase-7 Level-3 LLVM MC layer (§7.4), the LLVM twin of the binutils
    leg, generated from the same isa/parser-opcodes.yaml. The notation freeze being
    complete, this leg is now unblocked.
    emit_llvm (tools/parser-gen) writes a TableGen fragment
    (toolchain/generated/parser-llvm.td); nix/parser-llvm.nix patches the in-tree
    RISC-V target (RISCVInstrInfoXparser.td, included from RISCVInstrInfo.td) with it,
    scoped to LLVM_TARGETS_TO_BUILD=RISCV to keep the from-source rebuild small. The
    ops live in the DEFAULT RISCV decoder namespace with NO predicate — always
    assemblable, the analogue of the binutils INSN_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
2026-08-23 feat(parser-gen): LLVM MC leg L2 — custom-3 moves via a generated PRReg register class (#62)
    Extends the LLVM machine-code layer (Phase 7 §7.4) from L1's immediate-only
    custom-0 ops to the five custom-3 parser moves — prs.mv.x.p, prs.mv.p.x,
    prs.ld.immed, prs.cam.read, prs.array.read — all still generated from the single
    source isa/parser-opcodes.yaml.
    parser_gen's emit_llvm now emits a PRReg RegisterClass (the Cpreg[28:24] p-register
    file, p0..p31) whose ABI-style aliases (paccum, pnext, pcurhdr, ...) are single-sourced
    from a new p_registers.*.alias yaml field and ride RISC-V's existing ABIRegAltName index,
    so llvm-mc accepts both p15 and paccum and llvm-objdump prints the alias. T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
2026-08-23 feat(parser-gen): LLVM MC leg L3a — destination decoration for load/cam/length Hybrid forms (#63)
    Extend the parser-patched LLVM MC layer (L1 immediates, L2 custom-3 moves) with the
    destination pseudo-register decoration on the load/cam/length Hybrid forms, generated
    from the same isa/parser-opcodes.yaml:
    - paccum on load (rides D[30]=0, cosmetic-but-fixed so it round-trips)
    - paccum / pnext on cam (rides D[30], 0/1 — a real discriminator)
    - pcurhdr on length family (rides F2[20:19])
    Each dest keyword is consumed by a small custom ParserMethod before the generic
    p-register fallback, and printed back by a PrintMethod; encode/decode stay automatic
    because the token rid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
    [parser-opcodes.yaml]
2026-08-23 feat(parser-gen): LLVM MC leg L3b — prose-sugar operands (full binutils parity) (#64)
    Complete the LLVM MC leg (Phase 7, §7.4) with the prose-sugar operand family, generated
    from the same isa/parser-opcodes.yaml as the binutils leg:
    - pcurptr+N (load Offset)
    - pmeta+N (store/storeimm metadata-frame Offset)
    - paccum[i] (Pos)
    - value:mask (cmp Value + Mask)
    - mult:min (length Shift=log2(mult) + Len)
    emit_llvm swaps each prose field's uimm for a custom AsmOperandClass (predicates reuse
    RISC-V's stock isUImmN); the patch adds five ParserMethods and three PrintMethods. Each op
    keeps ONE def that assembles both the prose and the Hybrid spelling — the parser dispatches
    the P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
2026-08-23 feat(parser-clang): C0 — stand up parser-patched Clang (build only, no builtins) (#65)
    The Clang leg of the Phase-7 toolchain ladder (§7.4). C0 stands up the
    from-source Clang build and proves the parser MC layer reaches it — before any
    __builtin_riscv_prs_* codegen (that lands in C1).
    nix/parser-clang.nix builds `clang` against the parser-patched libLLVM
    (clang-unwrapped.override { libllvm = <the L3 llvm>; }, RISCV-only,
    clang-tools-extra off). Clang's integrated assembler IS the LLVM MC layer, so
    this clang parses/encodes the prs.* mnemonics with no extra flags, inheriting
    the L1–L3b patch for free — no clang source touched.
    parser-clang-check proves it: (1) clang's integrated-a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
2026-08-24 feat(parser-clang): C1 — __builtin_riscv_prs_* custom-0 builtins (light path) (#66)
    The Clang builtins leg of the Phase-7 toolchain ladder (§7.4), light path:
    builtin -> prs.* inline asm. Every custom-0 assembly VARIANT (the size/attribute-
    suffix cross-product crossed with the destination discriminator) becomes one
    __builtin_riscv_prs_* — 67 in all (e.g. prs_load_h_be, prs_cam_h_stp_pnext,
    prs_cmpib_stopsub) — generated from the same isa/parser-opcodes.yaml.
    tools/parser-gen gains emit_builtin, emitting three artifacts into
    toolchain/generated: parser-clang-builtins.{td,inc,tsv}. The clang patch
    (nix/parser-clang/parser-clang.patch, applied via extraPatches) is a one-line
    BuiltinsRI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
    [parser-clang-builtins.tsv]
2026-08-24 feat(parser-clang): C2 — Clang __builtin_riscv_prs_* slice on Spike (#67)
    The Phase-0 C slice, compiled through the parser-patched Clang using the
    mnemonic-form __builtin_riscv_prs_* builtins (C1), running on the standalone
    parser Spike over the 22-case corpus == the golden model. Closes §7.4's "the
    parser unit reachable from Clang without inline asm".
    - tests/cva6-parser/parser_builtins.h (new): dual-path shim. Under
    -DPRS_USE_BUILTINS each raw-field prs_*(...) macro dispatches — at compile
    time via __builtin_choose_expr on the constant size/E/dest/stp/er fields — to
    the matching variant builtin (e.g. prs_load(SZ_H,1,12) ->
    __builtin_riscv_prs_load_h_be(12)); PRS_EMIT become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
2026-08-24 feat(phase7): C3 — Clang builtins for the custom-3 register-operand moves (#68)
    Adds first-class Clang builtins for the 4 custom-3 register-operand
    "move" ops — the last parser group reachable today only via inline
    `.insn` / raw-field intrinsics — letting C read/write the parser's
    p-registers directly:
    __builtin_riscv_prs_mv_x_p(preg) GPR <- p-register
    __builtin_riscv_prs_mv_p_x(preg, val) p-register <- GPR
    __builtin_riscv_prs_cam_read(preg, key) GPR <- CAM.lookup(key)
    __builtin_riscv_prs_array_read(preg,key) same shape (S bit)
    The p-register is a `_Constant unsigned int` (0..31, Sema-range-checked)
    baked into the mnemonic as `p<N>` by CodeGen; the GPRs are real =r/r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
    [parser-clang-moves.tsv]
2026-08-25 docs: Phase 7 follow-up framing + pre-purchase FPGA platform assessment (#69)
    * docs(phase7): frame the deferred tail as explicit follow-up work
    Phase 7's exit criterion is met and the full toolchain ladder a C
    programmer needs is built (binutils, LLVM MC, Clang C0–C3, Spike, QEMU).
    Reframe the remaining items as a deliberately-deferred follow-up tail
    rather than pending phase work, and note that Phase 8 can begin (it
    reaches hardware via .insn/inline-asm and does not depend on the
    Clang/GCC builtin surface).
    - docs/phase-7-toolchain.md: new "Follow-up / deferred work" section
    enumerating each item (optional GCC builtins; the unfrozen
    prs.ld.immed immediate spelling; full upstream ri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
2026-08-26 feat(fpga): Gowin GW5AST-138 feasibility microVM + CVA6 capacity probe (#70)
    * feat(fpga): Gowin GW5AST-138 feasibility microVM + CVA6 capacity probe
    Phase-8 pre-purchase gate for the Sipeed Tang Mega 138K Pro (Gowin
    GW5AST-138), answered in software with no board attached via a reproducible
    microvm.nix guest that presents the license-locked MAC on a QEMU user NIC.
    Tier-1 (license/device gate) = GO: the Education/NODELOCK license synthesizes
    AND place-and-routes GW5AST-LV138FPG676AC1/I0 (blinky bitstream produced),
    despite Sipeed listing the part as wanting the commercial IDE.
    Tier-2 (CVA6 capacity) = measured: with a raw->cleaned netlist swap and a
    4-constant patch (CVA6Cfg.{ASID_WIDTH,V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
    [blinky.v]
2026-08-26 docs(fpga): add explicit buy-decision verdict (Tang Mega 138K Pro) (#71)
    The assessment + Gowin microVM docs had the findings but never stated the
    actual recommendation. Add a TL;DR "should I buy it, and will it work?" table
    + recommendation at the top of fpga-platform-assessment.md, and a matching
    "Bottom line" at the top of gowin-microvm.md.
    Verdict: yes it works for CVA6 + parser (fits with BRAM mapping; license
    synth+PnRs the part; best-in-class 10GbE/SFP+ I/O), but it's the endgame board
    — highest integration effort (no CVA6 ref design; hand-map SRAM macros to Gowin
    BSRAM). Fastest prototype path is a Xilinx board with the official CVA6 FPGA
    reference design; buy the Tang Mega for th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
2026-08-26 docs(fpga): pin the 138K Pro SKU + note the hardened Andes A25/AE350 (#72)
    Add a "which SKU" subsection to the assessment TL;DR: buy the Tang Mega 138K
    **Pro** (GW5AST-LV138FPG676AC1/I0 — the exact part validated here), not the
    non-Pro 138K, which shares the die but has no SFP+ and caps transceivers at
    8.0 Gbps (below 10 GbE line rate). Decision recorded: Pro ordered (2026-08).
    Also clarify the on-die RISC-V: the GW5AST-138 embeds a hardened Andes A25 +
    AE350 subsystem (real silicon, consumes no LUTs) on both SKUs — but it's a
    fixed RV32 core, so it can't host the custom parser ISA and doesn't replace
    CVA6+parser (which still lives in fabric). It's a free control-plane /
    housekeeping CP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
2026-08-26 docs(fpga): document Alinx AX7325B as the Xilinx 10G fallback board (#73)
    Record the Alinx AX7325B (Kintex-7 XC7K325T) in assessment §6 as the
    documented alternative to the ordered Tang Mega 138K Pro. Rationale: it's the
    same FPGA as the Genesys 2 (the official CVA6 corev_apu/fpga target), so CVA6
    bring-up is turnkey — fixing the Tang Mega's Gowin-integration cost — while
    exceeding its 10G I/O: 4× SFP+ (10G) + 1× QSFP+ (40G), 2GB DDR3 (+SODIMM to
    8GB), PCIe Gen2 x8.
    Includes the confirmed spec table and the real buy caveats: 325T is above free
    Vivado WebPACK (paid Vivado Standard or AMD University Program), want a -2
    speed grade for 10.3125G GTX line rate, and a throughput reality ch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
2026-09-07 Phase 8 M1: parser unit alone on the Tang Mega — flow_keys == model on the board (#74)
    * feat(fpga): Tang Mega 138K Pro board bring-up — our RTL runs on hardware
    The board arrived, so Phase 8 is unblocked. This lands the whole getting-started
    ladder as reproducible Nix, plus a foundation doc that records what actually
    works. Everything is verified on the physical board.
    Programming path (nix/fpga.nix, scripts/fpga-*.sh):
    nix run .#fpga-detect scan the JTAG chain
    nix run .#fpga-build our RTL -> .fs via Gowin EDA in the microVM
    nix run .#fpga-load -- <fs> program SRAM (volatile)
    nix run .#fpga-flash -- <fs> program SPI flash (persistent)
    Toolchain is now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
2026-09-08 feat(fpga): Phase 8 M2 — host packet injection, 22/22 suite parses on the board (#75)
    The whole Phase-6 directed suite now runs on real silicon over a wire. m2_top
    receives a packet from the host over UART, loads it into parser_pktbuf's write
    port, runs the same baked parse graph, and streams flow_keys back; the host
    (fpga-m2-inject) diffs every result against libparsermodel. All 22 cases match
    byte-for-byte (flow_keys + exit code). 5306 LUT/ALU, 2831 FF, 0 latches.
    Return path: the USB debug UART is fabric-TX-only — its RX net (N16) is a
    dedicated CPU pin PnR refuses (PR2017), wired to the hardened Andes CPU. So M2
    uses an external 3.3 V USB-UART adapter on PMOD2 (uart_rx C21, uart_tx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
2026-09-12 feat(fpga): Phase 8 M3a — CVA6 does not fit the GW5AST-138 → Xilinx pivot + reproducible openXC7 verify-before-buy (#76)
    M3a is the project gate: does stock RV64GC CVA6 (cv64a6_imafdc_sv39) fit the
    host FPGA? Answer — NO on the Gowin GW5AST-138, comfortably YES on Xilinx 7-series.
    Gowin path, productized as `nix run .#fpga-m3-core-rtl -- s0|s1|s2` (nix/fpga-m3.nix,
    scripts/fpga-m3-core-rtl.sh, fpga/tang-mega-138k-pro/m3-core.tcl):
    - stock-CVA6 synth-input prep that keeps module hierarchy so GowinSynthesis can infer BSRAM
    - s1 reproduced the failure (0 BSRAM, 558k DFF, RP0001, ~4x over); root-caused to the
    per-byte write-enable being lowered to 64 per-bit write conditionals GowinSynt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
    [cva6_fit_top.v, cva6_fit_top.xdc, m3_ramtest.v, strip-translate-off.py, tc_sram_wrapper.sv, tc_sram_wrapper_cache_techno.sv]
2026-09-17 docs(fpga): M3a openXC7 fit result — open flow over-reports CVA6 LUTs ~12x (#77)
    The reproducible `nix run .#fpga-m3-xilinx-fit` flow completed after ~4.5 days
    (ABC9 LUT mapping alone ≈107 h, single-threaded). Record the numbers and, more
    importantly, what they mean.
    yosys synth_xilinx mapped stock cv64a6_imafdc_sv39 to 628,762 LUTs; nextpnr-xilinx
    packed that to 640,815/407,600 SLICE_LUTX (157%) and failed placement ("no Bels
    remaining of type SLICE_LUTX") — no route, no Fmax. FF 24,218, DSP48E1 71,
    RAMB36E1 36 all fit comfortably; CARRY4 is only 1,629.
    The 628k LUT figure is a yosys/abc9 mapping-quality artifact (~12x), not CVA6's
    true size: Vivado (PERCIVAL ~40-50k LUT6 on this ex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
2026-09-17 feat(fpga): reproducible Vivado LUT-oracle target for M3a verify-before-buy (#78)
    The openXC7 flow (nix run .#fpga-m3-xilinx-fit) mapped stock CVA6 to 628,762
    LUTs (nextpnr 157% -> PnR place failure), but that is a ~12x abc9 mapper-quality
    artifact, not the design's real size: yosys inferred only 1,629 CARRY4 (Vivado
    maps CVA6's 64-bit adders onto carry chains), and the repo's own non-flatten
    Gowin open flow lands at the same ~640k while Vivado (PERCIVAL, Tom Herbert)
    puts CVA6 at ~50k LUT6. The open flow is a good FF/DSP/BRAM check but cannot
    certify the LUT fit for this arithmetic-heavy core.
    This adds the trustworthy LUT check as a reproducible nix target, mirroring the
    openXC7 one:
    n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
2026-09-21 feat(fpga): Phase 8→9 pre-purchase validation — AX7325B is GO, all A–D items proven no-board (#79)
    Retires all pre-purchase gateware+software risk for the ALINX AX7325B
    (xc7k325tffg900-2) as reproducible nix run targets on hp5, no board:
    * A1 free-Basic Vivado does full impl+bitstream on the 325T
    * A2 turnkey CVA6 SoC+DDR3 routes and closes timing on the die
    * B3 AX7325B DDR3 MIG pinout legal; B4 AX7325B CVA6 port builds+fits (~39%)
    * C5 10G MAC builds+fits+meets 156.25 MHz Fmax (co-resides with CVA6 ~40%)
    * D6.1 306-packet corpus == golden on Spike+QEMU (one re-arming boot)
    * D6.2 RTL parser FU re-arms through the CVA6 core == golden; proved safe
    under formal (parse_rearm_i free),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
2026-09-27 docs(phase-8): log ALINX board-selection correspondence — SKU decision now open
    Phase 8 validation stands (GO on the 325T fabric), but ALINX pre-sales proposed a
    device change, so record the exchange and the open decision:
    * Yae Wu (sales) -> our reply (AI infra, 40G now -> 400/800G) -> Fernand Xie (FAE)
    recommends UltraScale+ AXKU15 (XCKU15P) + 40G QSFP FMC over Kintex-7, offering an
    existing 40G UDP reference design.
    * Fact-check: AMD 40G Ethernet Subsystem is US/US+ only (moot — we use our own open
    MAC, C5-proven on the 325T); K7 -2 GTX FFG900 do 10.3125 Gb/s so 40G=4x10G is fine;
    100G+/lane genuinely needs GTY -> US+/Versal; and the omitted catch — XCKU15P is not
    in the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
